smicbee/CoffeeRoast/README.md

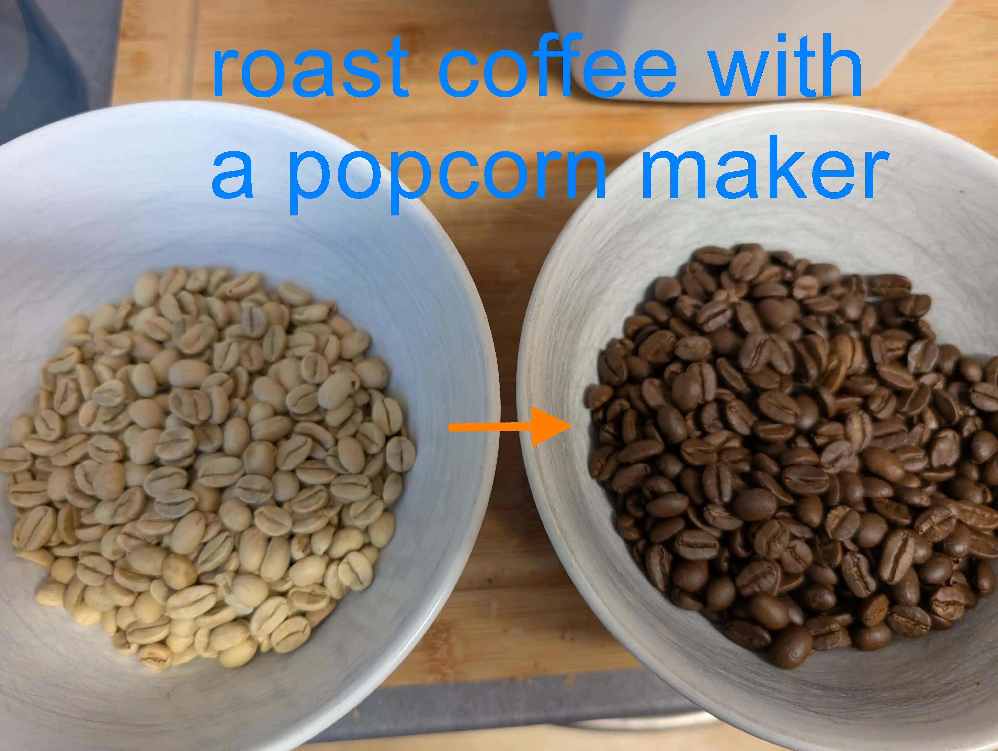
[picture p1: docu/assets/img/rel/headline.webp]
CoffeeRoast headline image for social media


# CoffeeRoast

We built a coffee roaster from a popcorn machine by adding temperature control. It follows a reproducible roast curve.

Kitchen flow


## Used Components

**Microcontroller:** LilyGo T-Display S3 ESP32-S3 (probably overkill, but it has a nice display and WiFi functionality if needed)  
From: [Amazon](https://www.amazon.de/LILYGO-T-Display-S3-Entwicklungsboard-Normalbildschirm-schwarzem/dp/B0BRTT727Z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)

**Popcorn Maker:** [Severin Popcorn-Maker](https://popcorn-rezepte.de/severin-pc-3751-popcornautomat-weiss-heissluft)  
From: Ebay/Kleinanzeigen for 5-10€. People often get this as a gift, use it once or not at all, and then sell it on eBay.

**Temperature Sensor:** MAX6675 Temperature Sensor, K Type  
From: [Amazon](https://www.amazon.de/dp/B0DFM7SJ3Z?ref=ppx_yo2ov_dt_b_fed_asin_title)

**Solid State Relay:** Solid-State-Relay SSR-40DA  
From: [Amazon](https://www.amazon.de/dp/B0CDKCBJRT?ref=ppx_yo2ov_dt_b_fed_asin_title)

Cables, drills, screwdriver, soldering iron

## Instructions

To modify the roaster, we had to:
* Add a temperature sensor
* Add a solid-state relay to the heater
* Add a PWM transistor to the fan

First, we took apart the popcorn maker. It basically consists of two elements: heating coils and a fan for the air.  
These popcorn makers are engineered to the limit, so please be gentle with them as they are made of a lot of plastic. We destroyed a couple until we got it right. Even then, the plastic melted on the third continuous roast.

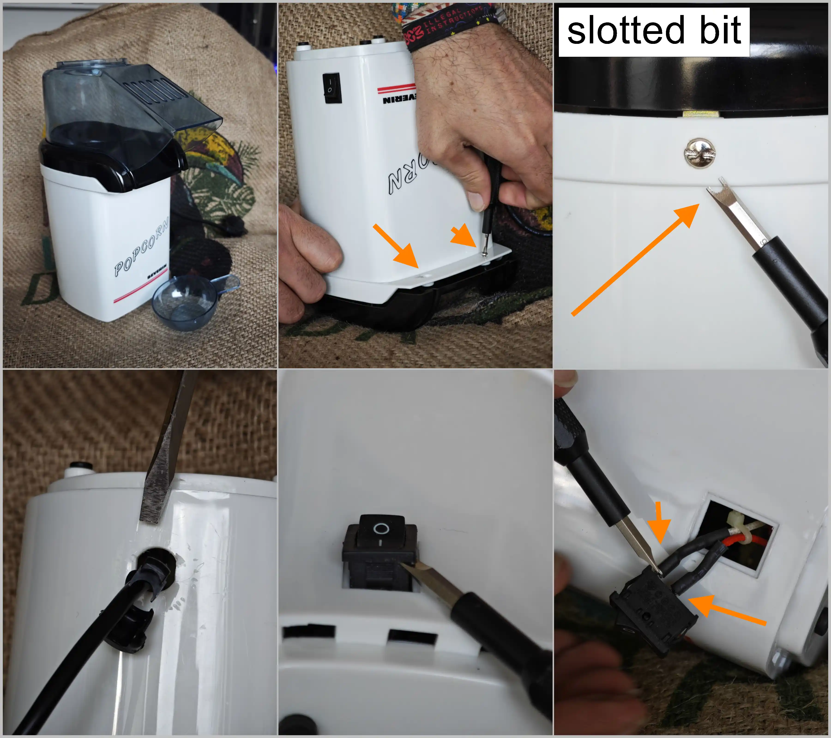
[picture p3: docu/assets/img/rel/open_case.webp]
Open popcorn maker casing


The main power switch connects the 230V from the outlet directly to the heating coils. The fan is connected to the heating coil in a way that ~24V AC goes through a rectifier (4 diodes) and is converted from AC to DC.

In the first step, we needed to decouple the heating coils from the fan and make the heating coil controllable using our solid-state relay. We disconnected the fan from the diodes so we could run it from an external power supply providing 24V later on.  
The heating coil was then soldered directly to the neutral conductor (blue wire). The red wire was cut, and the solid-state relay was installed in between so we could control the power of the heating element using PWM later.

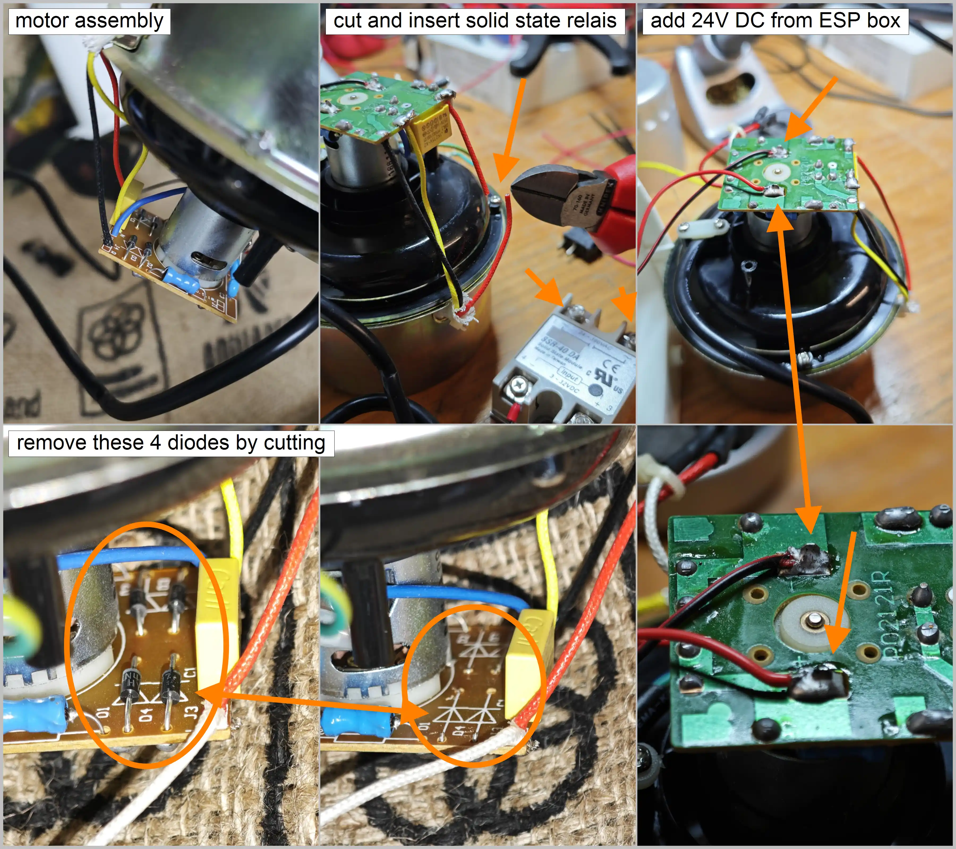
[picture p4: docu/assets/img/rel/power_motor_w_24V.webp]
Power and motor wiring with 24V supply


An external or lab power supply was used to provide 24V DC to the fan, so it runs permanently. The fan can take from 4V to 30V. We can adjust the voltage to control the speed or later use a GPIO, a diode, and a transistor to control it from the ESP32. The ESP ensures a smooth start of the fan. We broke one of the fans due to rapid spin up/down.

We drilled a hole in the top metal container to fit the thermocouple inside the roasting chamber.  
**Note:** If the temperature sensor touches the metal casing, it won't work properly. We insulated the sensor with Kapton tape or a non-conductive washer. The temperature reading is 0°C if the motor is spinning and no insulation was used. This is handled by the code to be filtered out, but the roaster will go into fail-safe mode after 30s of nonsensical temperature readings and spin up the fan to 100%.

The other 4 pins go into the ESP32 (VCC = 5V, GND = Ground, CLK = GPIO_13, CS = GPIO_12, DO = GPIO_11).

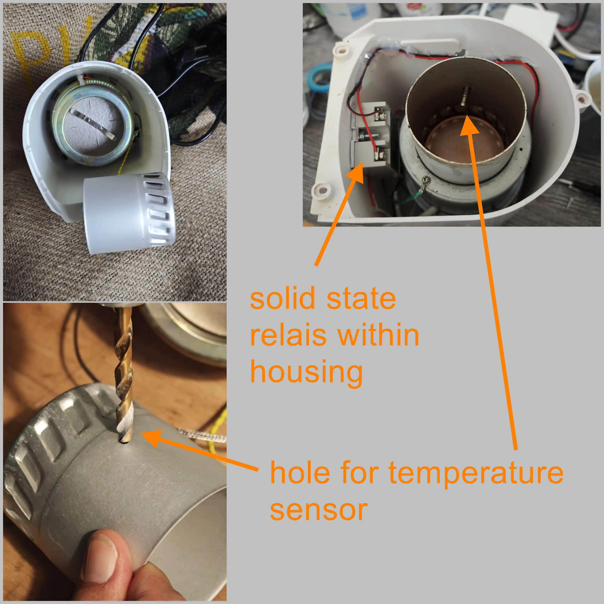
[picture p5: docu/assets/img/rel/add_sensor_and_hole.webp]
Thermocouple sensor installed in roasting chamber


Also, the solid-state relay is connected to the ESP32. In our case, the voltage provided by the GPIO was sufficient to control the solid-state relay, so we controlled it directly via the GPIO. If this does not work, you will need a separate transistor and a 5V supply for the SSR.  
The SSR uses GPIO_1 in our setup.

## Control Box

We 3D printed a box containing:
* ESP32
* 24V Fan PWM control
* SSR (solid-state relay) control
* Temperature sensor readout board

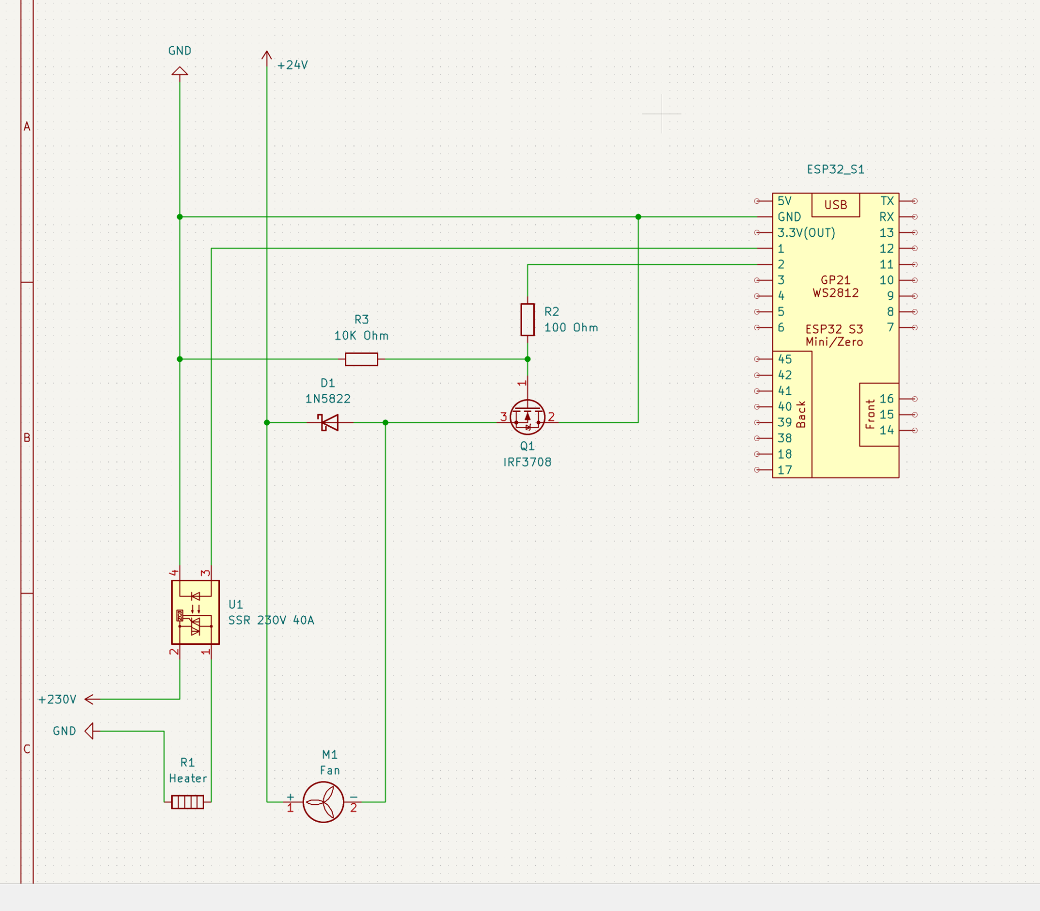
[picture p6: Schaltplan.png]
Wiring schematic of control box


And that's it!

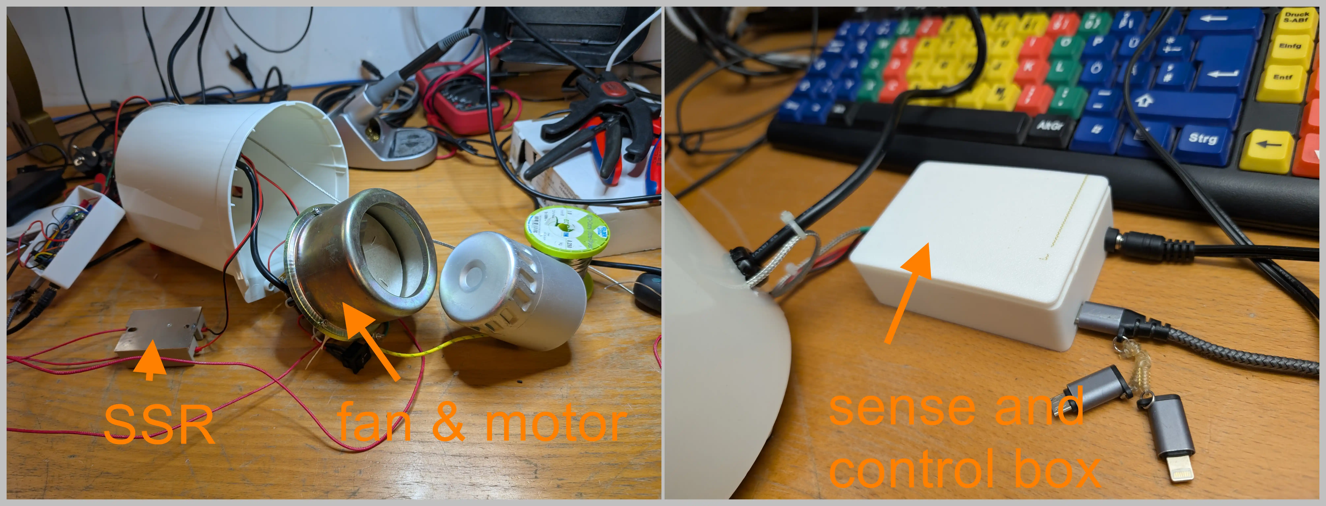
[picture p7: docu/assets/img/rel/assembly.webp]
Assembled control box with components


Initially, we wanted to use the ESP32 with Artisan (the software used for commercial products, e.g., Coffeelogic Nano), but we had no luck getting it to work with a PID. So, we decided to write our own software using C#. Communication is done via simple serial commands.  
You can send "get temp" via serial to the ESP32, and it will respond with the current temperature from the thermocouple.  
You can also send "set setpoint 255", which the ESP32 interprets to set the PWM duty cycle to 100% (255 = 100%, 128 = 50%, 0 = 0%).  
The firmware clamps `set setpoint` and `set fan` commands to the 0-255 PWM range and supports `get status` for a compact controller health line with state, temperature, heater, fan, fan target, and thermocouple error count.
The C# application can be found in the iRoastControl folder.

# Example Usage

Preparing the roaster for a new batch


Use no more than 100g of beans and roast in a well-ventilated area. Prepare for coffee skins flying _everywhere_.  
You can stop the roast at any time by flipping the on-off switch, which effectively disconnects the heater while keeping the cooling fan running.

[12s_roast.webm](https://github.com/user-attachments/assets/c60a7ab9-1068-4cd1-9d56-9880ee272cc1)

[12s video of 12min roasting](docu/assets/img/rel/12s_roast.webm)

# CoffeeRoast V2 Web

Die neue Steuerungsoberfläche liegt unter [`CoffeeRoast V2/`](CoffeeRoast%20V2/) und ist als moderne, responsive Webanwendung umgesetzt.

- Live-Verbindung zum bestehenden ESP32 über die Web Serial API
- vorhandenes serielles Protokoll und alle `.kpro`-Rezepte bleiben nutzbar
- Safety-Preflight, Failsafe, Vorheizen, Rösten und Abkühlen
- eingebauter Simulator, Canvas-Live-Plot und CSV-Export
- öffentlich bereitgestellt unter **https://coffeeroast.michaelbeetz.de/**

Für die USB-Verbindung wird Chrome oder Edge benötigt. Der Browser spricht direkt mit dem lokal ausgewählten USB-Gerät; der Webserver erhält keinen Zugriff auf den Controller.

# iRoastControl (Legacy)

iRoastControl is the control software. It comes with predefined roast curves you can use for your first roast.

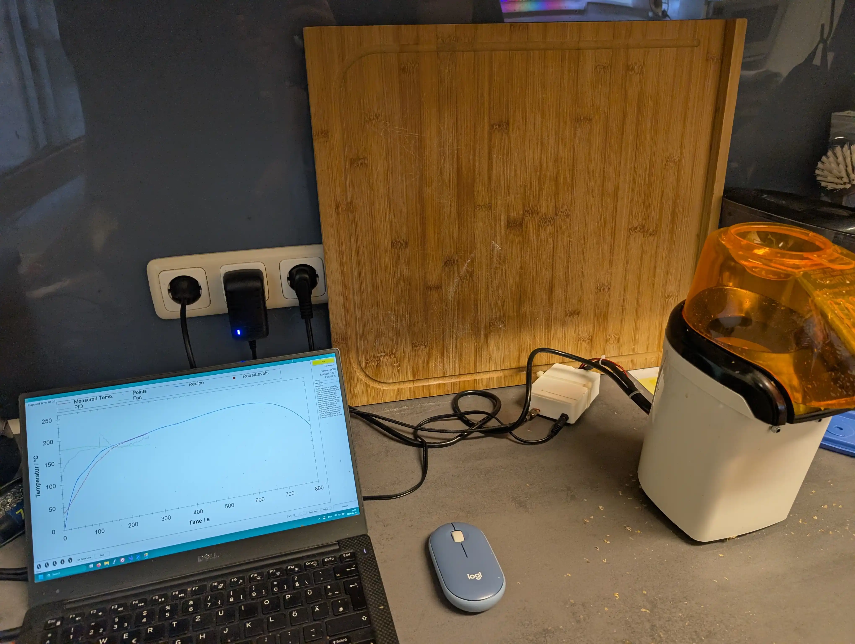
[picture p9: docu/assets/img/rel/roasting.webp]
iRoastControl software roasting curve view


## Build and Run on Windows

iRoastControl is a Windows Forms application for .NET Framework 4.7.2. Build it with Visual Studio 2022 and the ".NET desktop development" workload installed, including the .NET Framework 4.7.2 targeting pack or developer pack.

1. Connect the ESP32 roaster controller to the Windows PC over USB and confirm it appears as a COM port.
2. Open `iRoastControl Software/iRoastControl.sln` in Visual Studio.
3. Restore NuGet packages when Visual Studio prompts you, or use **Build > Restore NuGet Packages** before the first build. The project uses `packages.config`, so packages are restored into a repository-level `packages` folder.
4. Build the `Debug|Any CPU` or `Release|Any CPU` configuration, then press **Start** in Visual Studio or run the generated `iRoastControl.exe` from `iRoastControl Software/bin/Debug/` or `iRoastControl Software/bin/Release/`.

On startup the application scans available COM ports at `115200` baud, 8 data bits, no parity, one stop bit, and no handshake. It sends `hello` and expects the ESP32 firmware to answer `popcorn roaster`; after that it sends commands such as `get temp`, `set setpoint <0-255>`, and `set fan <0-255>`. If the app does not connect, check that the ESP32 firmware is running, no serial monitor has the port open, and the USB driver exposes the board as a COM port.

Roast recipes are loaded from the `Recipes` folder next to the running application. The source recipes live in `iRoastControl Software/Recipes/*.kpro` and are copied to the build output during the Visual Studio build. Add custom `.kpro` files to that folder before building, or copy them into `bin/Debug/Recipes/` or `bin/Release/Recipes/` beside the executable.

## First-Run Calibration and Safety Check

Before the first heated run, flash the ESP32 firmware, start iRoastControl, and leave the chamber empty. When you press "Run" from idle, the application requests `get status` from the controller and shows a preflight checklist. Confirm only after the thermocouple is insulated from the metal chamber, the fan moves air freely, the SSR is wired through the controller, ventilation is running, and the manual power cut-off is reachable.

Each roasting curve has three phases: pre-heating, running, and cool-down. When you click "Run" the first time, the application pre-heats the empty popcorn machine until the thermocouple reaches 180°C. This is when you add your coffee beans. After that, press "Run" again and the button will turn yellow. This is where the roasting curve starts. You can follow your roasting temperatures by watching the red graph. Pressing the "Run" button again will abort and start the cool-down phase, where the heating element turns off and only the fan runs. When the temperature drops below 60°C, the app returns to idle.

If the thermocouple returns repeated impossible readings, the firmware enters failsafe, turns the heater off, and drives the fan to 255/255. The app also treats a controller status containing `failsafe` as a blocked start until the wiring or sensor issue is fixed.

## UI

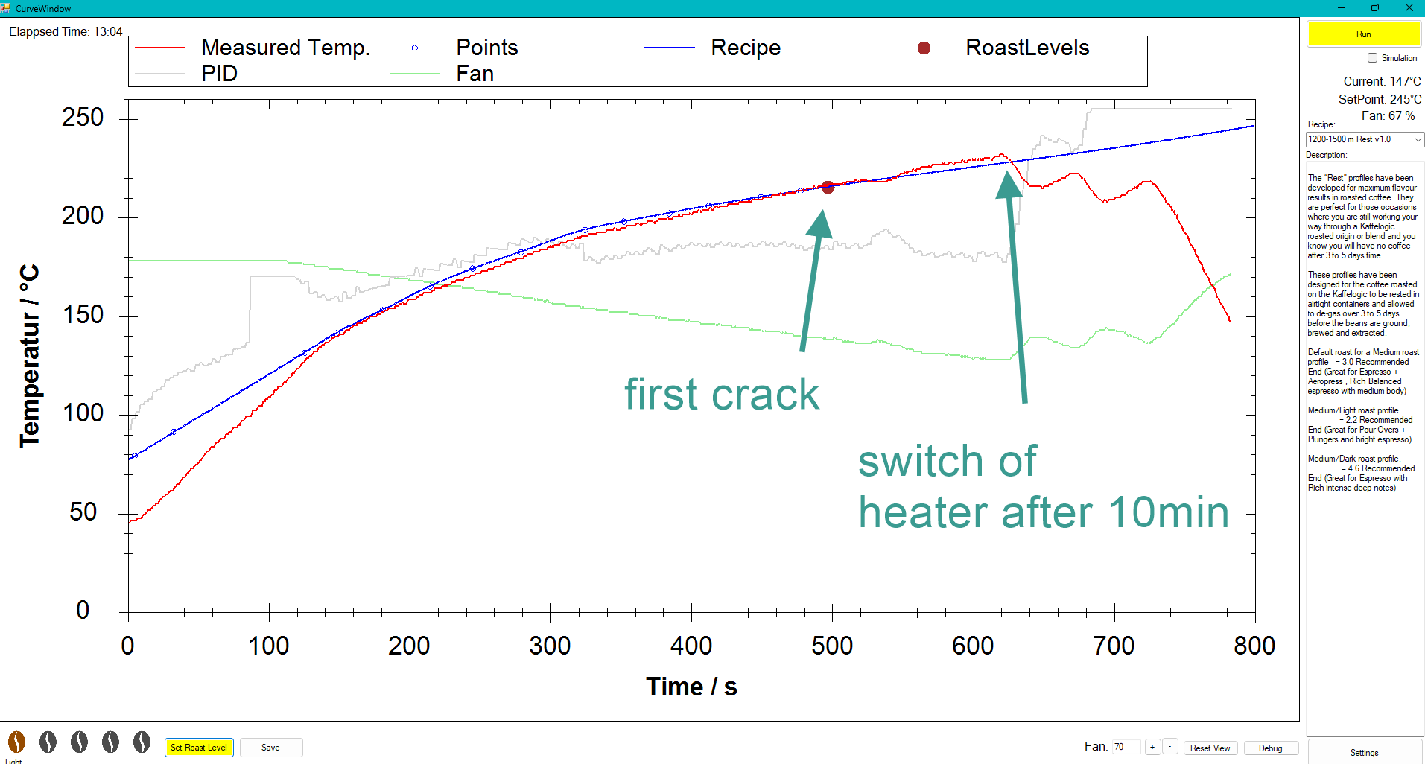
[picture p10: docu/assets/img/rel/iroastcontrol_overview.png]
iRoastControl software UI overview


At the moment, the curves are defined by some points in the source code, which get interpolated using a CubicSpline function. You can find the key points in `ControlClass.cs` in the function `generateDefaultCurve()`. Each point describes the temperature depending on the time in seconds, e.g., `targetPoints.Add(new PointF(660, 180));` means at 660s of the roasting curve, we should reach 180°C.  
Adjust as you like.

# Fails

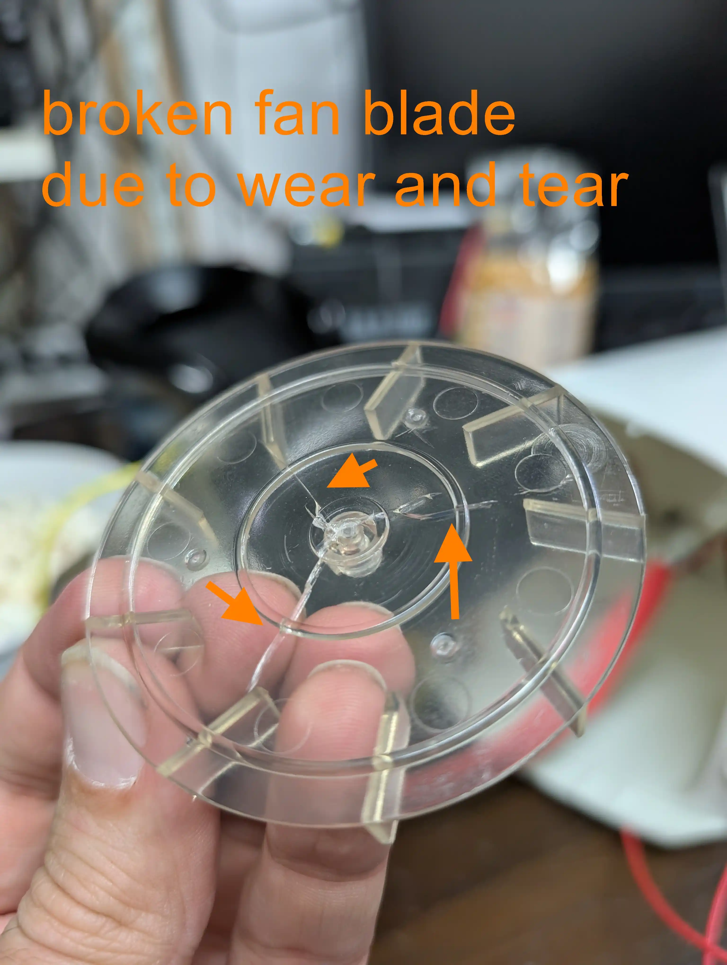
[picture p11: docu/assets/img/rel/fan_blade.webp]
Broken fan blade from old popcorn maker


If the popcorn maker is old (like 20 years), the fan blades are rather brittle and may break easily if used on full power.

**Note:** If the temperature sensor touches the metal casing, it won't work properly. We recommend insulating the sensor with Kapton tape or a non-conductive washer.

# Tips

* Cover any holes on top with Kapton tape to retain heat better. Plastic might melt a bit, though.
* Test the roast with actual popcorn, as it's cheaper if anything goes wrong.
* Experiment and change only one setting at a time.

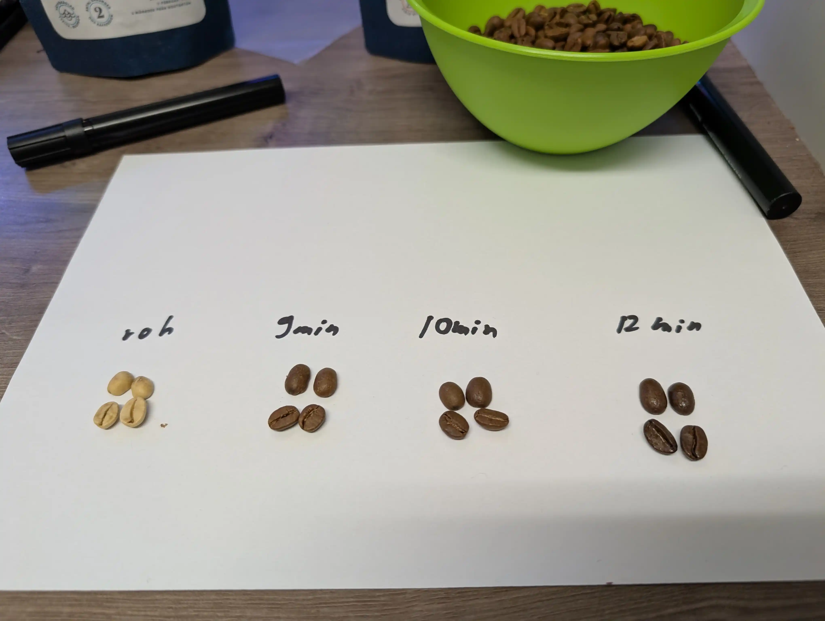
[picture p12: docu/assets/img/rel/result.webp]
Roasted coffee beans colors vs roast duration
