smicbee/CoffeeRoast/KiCAD/CoffeeRoast-Control-RevA/render/drc_report_after_silkscreen_cleanup.txt

** Drc report for CoffeeRoast-Control-RevA.kicad_pcb **
** Created on 2026-07-05T09:41:31+0200 **
** Report includes: Fehler, Warnungen **

** Found 110 DRC violations **
[silk_overlap]: Bestückungsdrucküberlappung
    Regel: Einschränkungen aus Platinenkonfiguration zum Bestückungsdruck; warning
    @(50,0000 mm, 82,6000 mm): Referenzfeld von TPGND
    @(50,0000 mm, 69,0000 mm): Abschnitt von U4 auf F.Silkscreen
[silk_over_copper]: Bestückungsdruck überlappt Lötstoppmaske
    Lokale Überschreibung; warning
    @(126,8500 mm, 30,4000 mm): Abschnitt von R8 auf F.Silkscreen
[silk_over_copper]: Bestückungsdruck überlappt Lötstoppmaske
    Lokale Überschreibung; warning
    @(126,8500 mm, 31,6000 mm): Abschnitt von R8 auf F.Silkscreen
[silk_over_copper]: Bestückungsdruck überlappt Lötstoppmaske
    Lokale Überschreibung; warning
    @(129,1500 mm, 30,4000 mm): Abschnitt von R8 auf F.Silkscreen
[silk_over_copper]: Bestückungsdruck überlappt Lötstoppmaske
    Lokale Überschreibung; warning
    @(129,1500 mm, 31,6000 mm): Abschnitt von R8 auf F.Silkscreen
[silk_over_copper]: Bestückungsdruck überlappt Lötstoppmaske
    Lokale Überschreibung; warning
    @(40,0000 mm, 39,0000 mm): Abschnitt von SW2 auf F.Silkscreen
[silk_over_copper]: Bestückungsdruck überlappt Lötstoppmaske
    Lokale Überschreibung; warning
    @(40,0000 mm, 45,0000 mm): Abschnitt von SW2 auf F.Silkscreen
[silk_over_copper]: Bestückungsdruck überlappt Lötstoppmaske
    Lokale Überschreibung; warning
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
[text_height]: Schrifthöhe außerhalb des zulässigen Bereichs (Einschränkungen aus Platinenkonfiguration zur Bestückungsdruckhöhe min. Breite 0,8000 mm; tatsächlich 0,6500 mm)
    Regel: Einschränkungen aus Platinenkonfiguration zur Bestückungsdruckhöhe; warning
    @(112,6000 mm, 46,5500 mm): Platinen-Text "IO37" auf B.Silkscreen
[text_height]: Schrifthöhe außerhalb des zulässigen Bereichs (Einschränkungen aus Platinenkonfiguration zur Bestückungsdruckhöhe min. Breite 0,8000 mm; tatsächlich 0,6500 mm)
    Regel: Einschränkungen aus Platinenkonfiguration zur Bestückungsdruckhöhe; warning
    @(112,6000 mm, 51,6300 mm): Platinen-Text "IO35" auf B.Silkscreen
[text_height]: Schrifthöhe außerhalb des zulässigen Bereichs (Einschränkungen aus Platinenkonfiguration zur Bestückungsdruckhöhe min. Breite 0,8000 mm; tatsächlich 0,6500 mm)
    Regel: Einschränkungen aus Platinenkonfiguration zur Bestückungsdruckhöhe; warning
    @(112,6000 mm, 54,1700 mm): Platinen-Text "IO0" auf B.Silkscreen
[text_height]: Schrifthöhe außerhalb des zulässigen Bereichs (Einschränkungen aus Platinenkonfiguration zur Bestückungsdruckhöhe min. Breite 0,8000 mm; tatsächlich 0,6500 mm)
    Regel: Einschränkungen aus Platinenkonfiguration zur Bestückungsdruckhöhe; warning
    @(112,6000 mm, 49,0900 mm): Platinen-Text "IO36" auf B.Silkscreen

** Found 0 unconnected pads **

** Found 0 Footprint errors **

** End of Report **
