smicbee/CoffeeRoast/KiCAD/CoffeeRoast-Control-RevA/render/drc_report_errors_only.txt

** Drc report for CoffeeRoast-Control-RevA.kicad_pcb **
** Created on 2026-07-05T19:19:03+0200 **
** Report includes: Fehler **

** Found 0 DRC violations **

** Found 0 unconnected pads **

** Found 0 Footprint errors **

** End of Report **
