smicbee/CoffeeRoast/KiCAD/CoffeeRoast-Control-RevA/render/drc_report_errors_only_after_silkscreen_cleanup.txt

** Drc report for CoffeeRoast-Control-RevA.kicad_pcb **
** Created on 2026-07-05T09:42:38+0200 **
** Report includes: Fehler **

** Found 0 DRC violations **

** Found 0 unconnected pads **

** Found 0 Footprint errors **

** End of Report **
