smicbee/CoffeeRoast/KiCAD/CoffeeRoast-Control-RevA/render/drc_report_full.txt

** Drc report for CoffeeRoast-Control-RevA.kicad_pcb **
** Created on 2026-07-05T09:37:32+0200 **
** Report includes: Fehler, Warnungen **

** Found 200 DRC violations **
[nonmirrored_text_on_back_layer]: Nicht-gespiegelter Text auf Rückseite
    Lokale Überschreibung; warning
    @(56,7000 mm, 21,1500 mm): Platinen-Text "GND" auf B.Silkscreen
[nonmirrored_text_on_back_layer]: Nicht-gespiegelter Text auf Rückseite
    Lokale Überschreibung; warning
    @(56,7000 mm, 23,6900 mm): Platinen-Text "3V3" auf B.Silkscreen
[nonmirrored_text_on_back_layer]: Nicht-gespiegelter Text auf Rückseite
    Lokale Überschreibung; warning
    @(56,7000 mm, 26,2300 mm): Platinen-Text "EN" auf B.Silkscreen
[nonmirrored_text_on_back_layer]: Nicht-gespiegelter Text auf Rückseite
    Lokale Überschreibung; warning
    @(56,7000 mm, 28,7700 mm): Platinen-Text "IO4" auf B.Silkscreen
[nonmirrored_text_on_back_layer]: Nicht-gespiegelter Text auf Rückseite
    Lokale Überschreibung; warning
    @(56,7000 mm, 31,3100 mm): Platinen-Text "IO5" auf B.Silkscreen
[nonmirrored_text_on_back_layer]: Nicht-gespiegelter Text auf Rückseite
    Lokale Überschreibung; warning
    @(56,7000 mm, 33,8500 mm): Platinen-Text "IO6" auf B.Silkscreen
[nonmirrored_text_on_back_layer]: Nicht-gespiegelter Text auf Rückseite
    Lokale Überschreibung; warning
    @(56,7000 mm, 36,3900 mm): Platinen-Text "IO7" auf B.Silkscreen
[nonmirrored_text_on_back_layer]: Nicht-gespiegelter Text auf Rückseite
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
    @(64,2500 mm, 74,5000 mm): Abschnitt von U3 auf F.Silkscreen
    @(72,0000 mm, 74,6000 mm): Referenzfeld von TP3V3
[silk_overlap]: Bestückungsdrucküberlappung
    Regel: Einschränkungen aus Platinenkonfiguration zum Bestückungsdruck; warning
    @(71,7500 mm, 74,5000 mm): Abschnitt von U3 auf F.Silkscreen
    @(72,0000 mm, 74,6000 mm): Referenzfeld von TP3V3
[silk_overlap]: Bestückungsdrucküberlappung
    Regel: Einschränkungen aus Platinenkonfiguration zum Bestückungsdruck; warning
    @(5,0000 mm, 44,5000 mm): Abschnitt von J2 auf F.Silkscreen
    @(10,0000 mm, 45,0000 mm): Referenzfeld von J2
[silk_overlap]: Bestückungsdrucküberlappung
    Regel: Einschränkungen aus Platinenkonfiguration zum Bestückungsdruck; warning
    @(43,0000 mm, 29,0000 mm): Referenzfeld von SW1
    @(40,0000 mm, 29,0000 mm): Abschnitt von SW1 auf F.Silkscreen
[silk_overlap]: Bestückungsdrucküberlappung
    Regel: Einschränkungen aus Platinenkonfiguration zum Bestückungsdruck; warning
    @(32,0000 mm, 15,0000 mm): Referenzfeld von F1
    @(19,0000 mm, 15,0000 mm): Abschnitt von F1 auf F.Silkscreen
[silk_overlap]: Bestückungsdrucküberlappung
    Regel: Einschränkungen aus Platinenkonfiguration zum Bestückungsdruck; warning
    @(10,0000 mm, 15,0000 mm): Referenzfeld von J1
    @(5,0000 mm, 14,5000 mm): Abschnitt von J1 auf F.Silkscreen
[silk_overlap]: Bestückungsdrucküberlappung
    Regel: Einschränkungen aus Platinenkonfiguration zum Bestückungsdruck; warning
    @(15,0000 mm, 21,5000 mm): Abschnitt von J1 auf F.Silkscreen
    @(10,0000 mm, 21,8000 mm): Referenzfeld von C4
[silk_overlap]: Bestückungsdrucküberlappung
    Regel: Einschränkungen aus Platinenkonfiguration zum Bestückungsdruck; warning
    @(50,0000 mm, 82,6000 mm): Referenzfeld von TPGND
    @(50,0000 mm, 69,0000 mm): Abschnitt von U4 auf F.Silkscreen
[silk_overlap]: Bestückungsdrucküberlappung
    Regel: Einschränkungen aus Platinenkonfiguration zum Bestückungsdruck; warning
    @(22,0000 mm, 70,6000 mm): Referenzfeld von TP24V
    @(22,0000 mm, 87,0000 mm): Abschnitt von U4 auf F.Silkscreen
[silk_overlap]: Bestückungsdrucküberlappung
    Regel: Einschränkungen aus Platinenkonfiguration zum Bestückungsdruck; warning
    @(56,1500 mm, 32,6000 mm): Abschnitt von R5 auf F.Silkscreen
    @(55,0000 mm, 33,0000 mm): Referenzfeld von R6
[silk_over_copper]: Bestückungsdruck überlappt Lötstoppmaske
    Lokale Überschreibung; warning
    @(132,0000 mm, 36,0000 mm): Platinen-Text "USB-C native data; VBUS sense only" auf F.Silkscreen
[silk_over_copper]: Bestückungsdruck überlappt Lötstoppmaske
    Lokale Überschreibung; warning
    @(109,0000 mm, 21,1500 mm): Platinen-Text "GND" auf B.Silkscreen
[silk_over_copper]: Bestückungsdruck überlappt Lötstoppmaske
    Lokale Überschreibung; warning
    @(109,0000 mm, 23,6900 mm): Platinen-Text "IO1" auf B.Silkscreen
[silk_over_copper]: Bestückungsdruck überlappt Lötstoppmaske
    Lokale Überschreibung; warning
    @(109,0000 mm, 26,2300 mm): Platinen-Text "IO2" auf B.Silkscreen
[silk_over_copper]: Bestückungsdruck überlappt Lötstoppmaske
    Lokale Überschreibung; warning
    @(109,0000 mm, 28,7700 mm): Platinen-Text "TXD0" auf B.Silkscreen
[silk_over_copper]: Bestückungsdruck überlappt Lötstoppmaske
    Lokale Überschreibung; warning
    @(109,0000 mm, 31,3100 mm): Platinen-Text "RXD0" auf B.Silkscreen
[silk_over_copper]: Bestückungsdruck überlappt Lötstoppmaske
    Lokale Überschreibung; warning
    @(109,0000 mm, 33,8500 mm): Platinen-Text "IO42" auf B.Silkscreen
[silk_over_copper]: Bestückungsdruck überlappt Lötstoppmaske
    Lokale Überschreibung; warning
    @(109,0000 mm, 36,3900 mm): Platinen-Text "IO41" auf B.Silkscreen
[silk_over_copper]: Bestückungsdruck überlappt Lötstoppmaske
    Lokale Überschreibung; warning
    @(109,0000 mm, 38,9300 mm): Platinen-Text "IO40" auf B.Silkscreen
[silk_over_copper]: Bestückungsdruck überlappt Lötstoppmaske
    Lokale Überschreibung; warning
    @(109,0000 mm, 41,4700 mm): Platinen-Text "IO39" auf B.Silkscreen
[silk_over_copper]: Bestückungsdruck überlappt Lötstoppmaske
    Lokale Überschreibung; warning
    @(109,0000 mm, 44,0100 mm): Platinen-Text "IO38" auf B.Silkscreen
[silk_over_copper]: Bestückungsdruck überlappt Lötstoppmaske
    Lokale Überschreibung; warning
    @(109,0000 mm, 46,5500 mm): Platinen-Text "IO37" auf B.Silkscreen
[silk_over_copper]: Bestückungsdruck überlappt Lötstoppmaske
    Lokale Überschreibung; warning
    @(109,0000 mm, 51,6300 mm): Platinen-Text "IO35" auf B.Silkscreen
[silk_over_copper]: Bestückungsdruck überlappt Lötstoppmaske
    Lokale Überschreibung; warning
    @(109,0000 mm, 54,1700 mm): Platinen-Text "IO0" auf B.Silkscreen
[silk_over_copper]: Bestückungsdruck überlappt Lötstoppmaske
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
    @(109,0000 mm, 46,5500 mm): Platinen-Text "IO37" auf B.Silkscreen
[text_height]: Schrifthöhe außerhalb des zulässigen Bereichs (Einschränkungen aus Platinenkonfiguration zur Bestückungsdruckhöhe min. Breite 0,8000 mm; tatsächlich 0,6500 mm)
    Regel: Einschränkungen aus Platinenkonfiguration zur Bestückungsdruckhöhe; warning
    @(109,0000 mm, 51,6300 mm): Platinen-Text "IO35" auf B.Silkscreen
[text_height]: Schrifthöhe außerhalb des zulässigen Bereichs (Einschränkungen aus Platinenkonfiguration zur Bestückungsdruckhöhe min. Breite 0,8000 mm; tatsächlich 0,6500 mm)
    Regel: Einschränkungen aus Platinenkonfiguration zur Bestückungsdruckhöhe; warning
    @(109,0000 mm, 54,1700 mm): Platinen-Text "IO0" auf B.Silkscreen
[text_height]: Schrifthöhe außerhalb des zulässigen Bereichs (Einschränkungen aus Platinenkonfiguration zur Bestückungsdruckhöhe min. Breite 0,8000 mm; tatsächlich 0,6500 mm)
    Regel: Einschränkungen aus Platinenkonfiguration zur Bestückungsdruckhöhe; warning
    @(109,2500 mm, 49,0900 mm): Platinen-Text "IO36" auf B.Silkscreen

** Found 0 unconnected pads **

** Found 0 Footprint errors **

** End of Report **
