smicbee/CoffeeRoast/KiCAD/CoffeeRoast-Control-RevA/render/drc_report_autorouted4.txt

** Drc report for CoffeeRoast-Control-RevA.kicad_pcb **
** Created on 2026-07-04T22:13:07+0200 **
** Report includes: Fehler, Warnungen **

** Found 89 DRC violations **
[silk_overlap]: Bestückungsdrucküberlappung
    Regel: Einschränkungen aus Platinenkonfiguration zum Bestückungsdruck; warning
    @(140,0000 mm, 49,0000 mm): Referenzfeld von J4
    @(135,0000 mm, 48,5000 mm): Abschnitt von J4 auf F.Silkscreen
[silk_overlap]: Bestückungsdrucküberlappung
    Regel: Einschränkungen aus Platinenkonfiguration zum Bestückungsdruck; warning
    @(135,0000 mm, 66,5000 mm): Abschnitt von J3 auf F.Silkscreen
    @(140,0000 mm, 67,0000 mm): Referenzfeld von J3
[silk_overlap]: Bestückungsdrucküberlappung
    Regel: Einschränkungen aus Platinenkonfiguration zum Bestückungsdruck; warning
    @(122,8500 mm, 41,4000 mm): Abschnitt von R10 auf F.Silkscreen
    @(124,0000 mm, 42,0000 mm): Referenzfeld von R11
[silk_overlap]: Bestückungsdrucküberlappung
    Regel: Einschränkungen aus Platinenkonfiguration zum Bestückungsdruck; warning
    @(122,8500 mm, 42,6000 mm): Abschnitt von R10 auf F.Silkscreen
    @(124,0000 mm, 42,0000 mm): Referenzfeld von R11
[silk_overlap]: Bestückungsdrucküberlappung
    Regel: Einschränkungen aus Platinenkonfiguration zum Bestückungsdruck; warning
    @(125,1500 mm, 41,4000 mm): Abschnitt von R10 auf F.Silkscreen
    @(124,0000 mm, 42,0000 mm): Referenzfeld von R11
[silk_overlap]: Bestückungsdrucküberlappung
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
    Lokale Überschreibung; warning
    @(95,1000 mm, 57,7000 mm): Abschnitt von U2 auf F.Silkscreen
[silk_over_copper]: Bestückungsdruck überlappt Lötstoppmaske
    Lokale Überschreibung; warning
    @(100,9000 mm, 52,3000 mm): Abschnitt von U2 auf F.Silkscreen
[silk_over_copper]: Bestückungsdruck überlappt Lötstoppmaske
    Lokale Überschreibung; warning
    @(45,0000 mm, 45,0000 mm): Referenzfeld von Q1
[silk_over_copper]: Bestückungsdruck überlappt Lötstoppmaske
    Lokale Überschreibung; warning
    @(124,0000 mm, 42,0000 mm): Referenzfeld von R11
[silk_over_copper]: Bestückungsdruck überlappt Lötstoppmaske
    Lokale Überschreibung; warning
    @(122,8500 mm, 44,4000 mm): Abschnitt von R11 auf F.Silkscreen
[silk_over_copper]: Bestückungsdruck überlappt Lötstoppmaske
    Lokale Überschreibung; warning
    @(122,8500 mm, 45,6000 mm): Abschnitt von R11 auf F.Silkscreen
[silk_over_copper]: Bestückungsdruck überlappt Lötstoppmaske
    Lokale Überschreibung; warning
    @(125,1500 mm, 44,4000 mm): Abschnitt von R11 auf F.Silkscreen
[silk_over_copper]: Bestückungsdruck überlappt Lötstoppmaske
    Lokale Überschreibung; warning
    @(125,1500 mm, 45,6000 mm): Abschnitt von R11 auf F.Silkscreen

** Found 0 unconnected pads **

** Found 0 Footprint errors **

** End of Report **
