smicbee/CoffeeRoast/KiCAD/CoffeeRoast-Control-RevA/render/kicad_happy/schematic.txt

=== Design Analysis [stage: pre_fab] ===
No findings.
