smicbee/CoffeeRoast/KiCAD/CoffeeRoast-Control-RevA/production/jlc-current-no-j1j4/drill/drill_report.txt

Drill report for CoffeeRoast-Control-RevA.kicad_pcb
Created on 2026-07-07T05:18:10+0200

Copper Layer Stackup:
    =============================================================
    L1 :  F.Cu                      front
    L2 :  B.Cu                      back

Drill file 'CoffeeRoast-Control-RevA.drl' contains
    plated through holes:
    =============================================================
    T1  0,300mm  0,0118"  (60 holes)
    T2  0,300mm  0,0118"  (12 holes)
    T3  0,600mm  0,0236"  (4 holes)  (with 4 slots)
    T4  0,800mm  0,0315"  (6 holes)
    T5  0,900mm  0,0354"  (10 holes)
    T6  1,000mm  0,0394"  (2 holes)
    T7  1,100mm  0,0433"  (7 holes)
    T8  1,300mm  0,0512"  (10 holes)

    Total plated holes count 111

Not plated through holes are merged with plated holes
    unplated through holes:
    =============================================================
    T9  0,650mm  0,0256"  (2 holes)

    Total unplated holes count 2
