smicbee/CoffeeRoast/tickets/76abb8d9-696f-4b31-948a-20c49ac45dec/description.md

# Rework UI

Die UI soll überarbeitet und schöner, moderner gemacht werden. auch der plot soll besser aussehen
