smicbee/CoffeeRoast/ESP32S3 Zero/RoastingControl/flashSettings.png

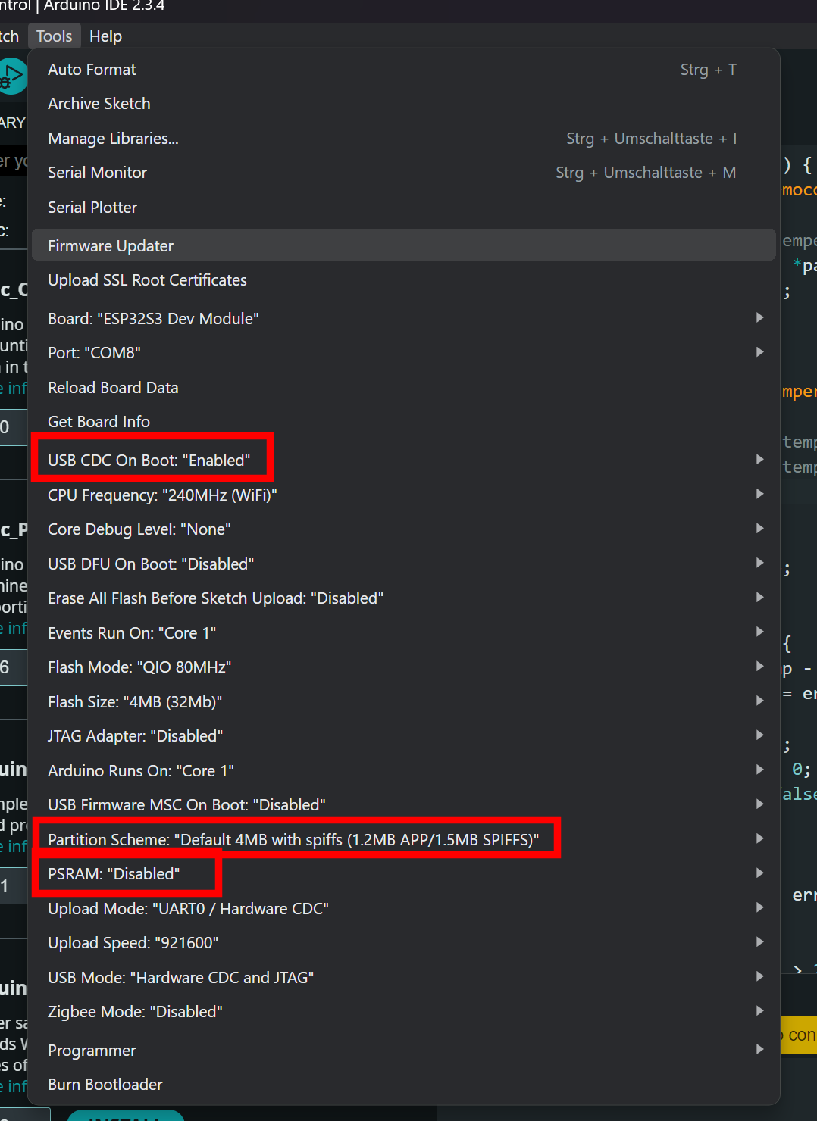
ESP32S3 Zero/RoastingControl/flashSettings.png
