smicbee/CoffeeRoast/iRoastControl Software/coffee-bean-256.png

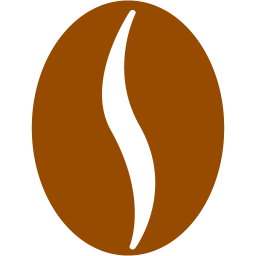
iRoastControl Software/coffee-bean-256.png
