smicbee/CoffeeRoast/KiCAD/CoffeeRoast-Control-RevA/docs/board_preview.png

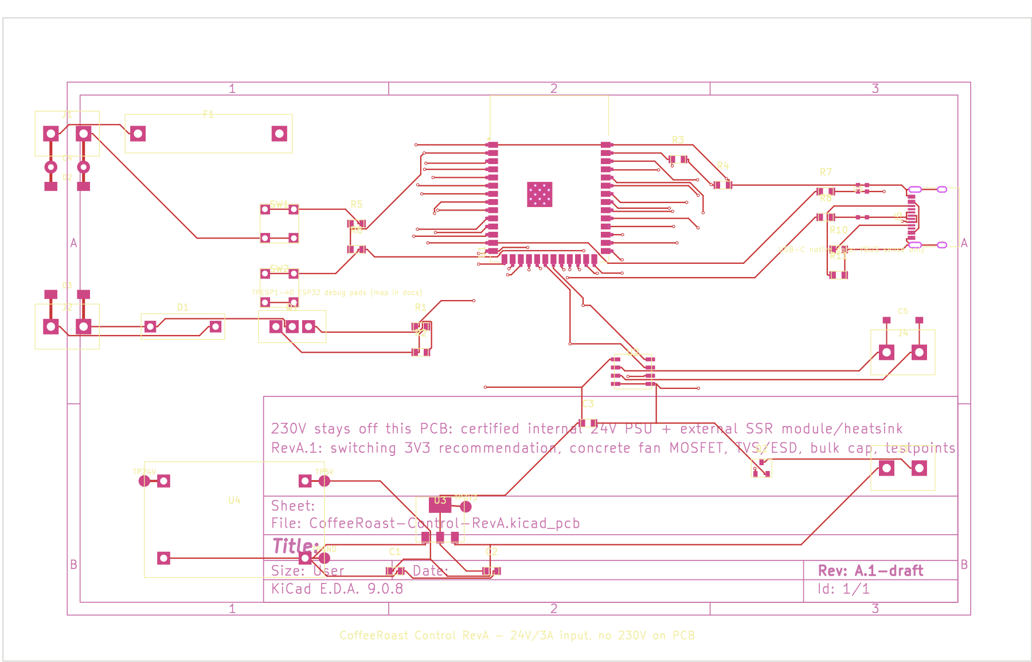
KiCAD/CoffeeRoast-Control-RevA/docs/board_preview.png
