smicbee/CoffeeRoast/KiCAD/CoffeeRoast-Control-RevA/render/back_kicad_happy_pass.png

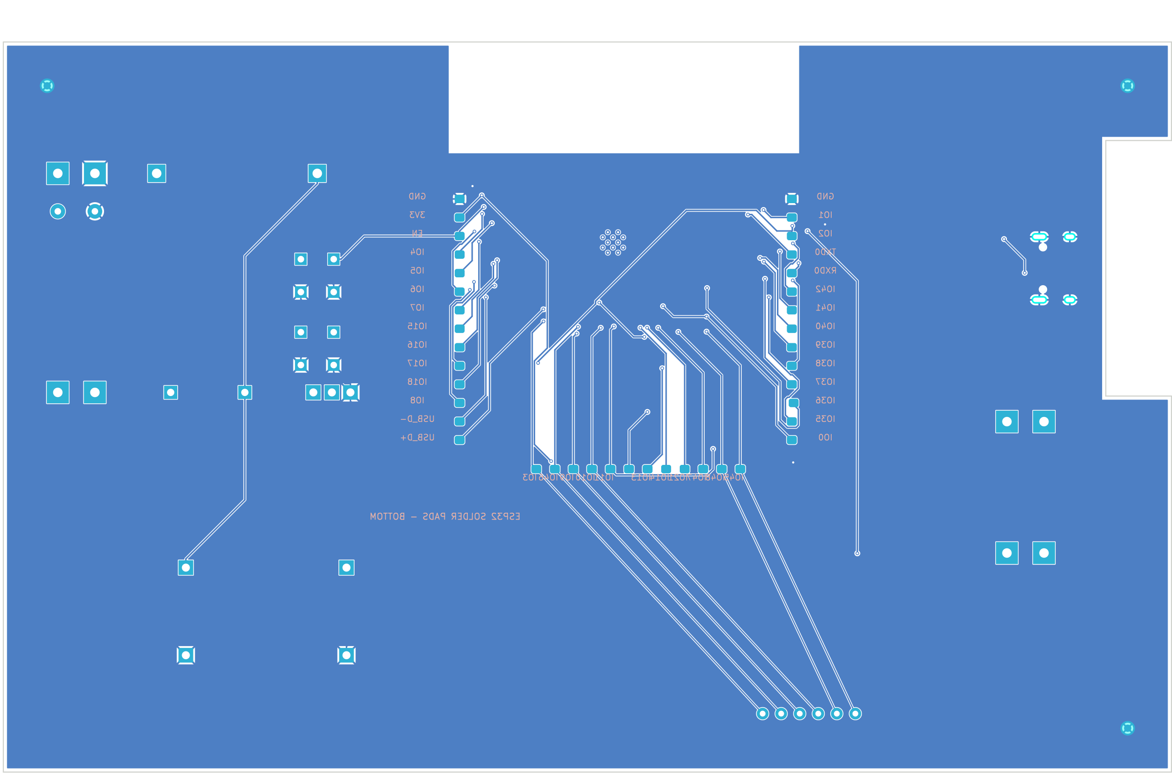
KiCAD/CoffeeRoast-Control-RevA/render/back_kicad_happy_pass.png
