smicbee/CoffeeRoast/KiCAD/CoffeeRoast-Control-RevA/render/back_silk_mask.png

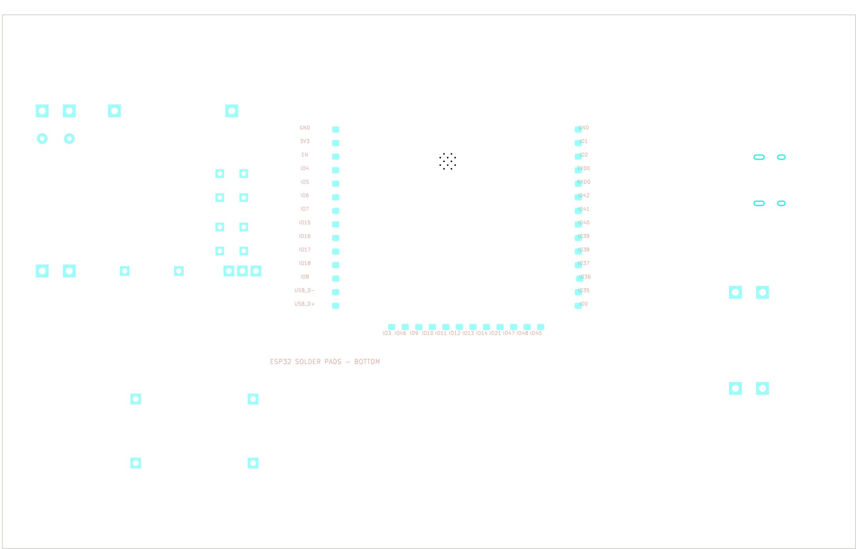
KiCAD/CoffeeRoast-Control-RevA/render/back_silk_mask.png
