smicbee/CoffeeRoast/KiCAD/CoffeeRoast-Control-RevA/render/coffeeroast_actual_traces_overlay.png

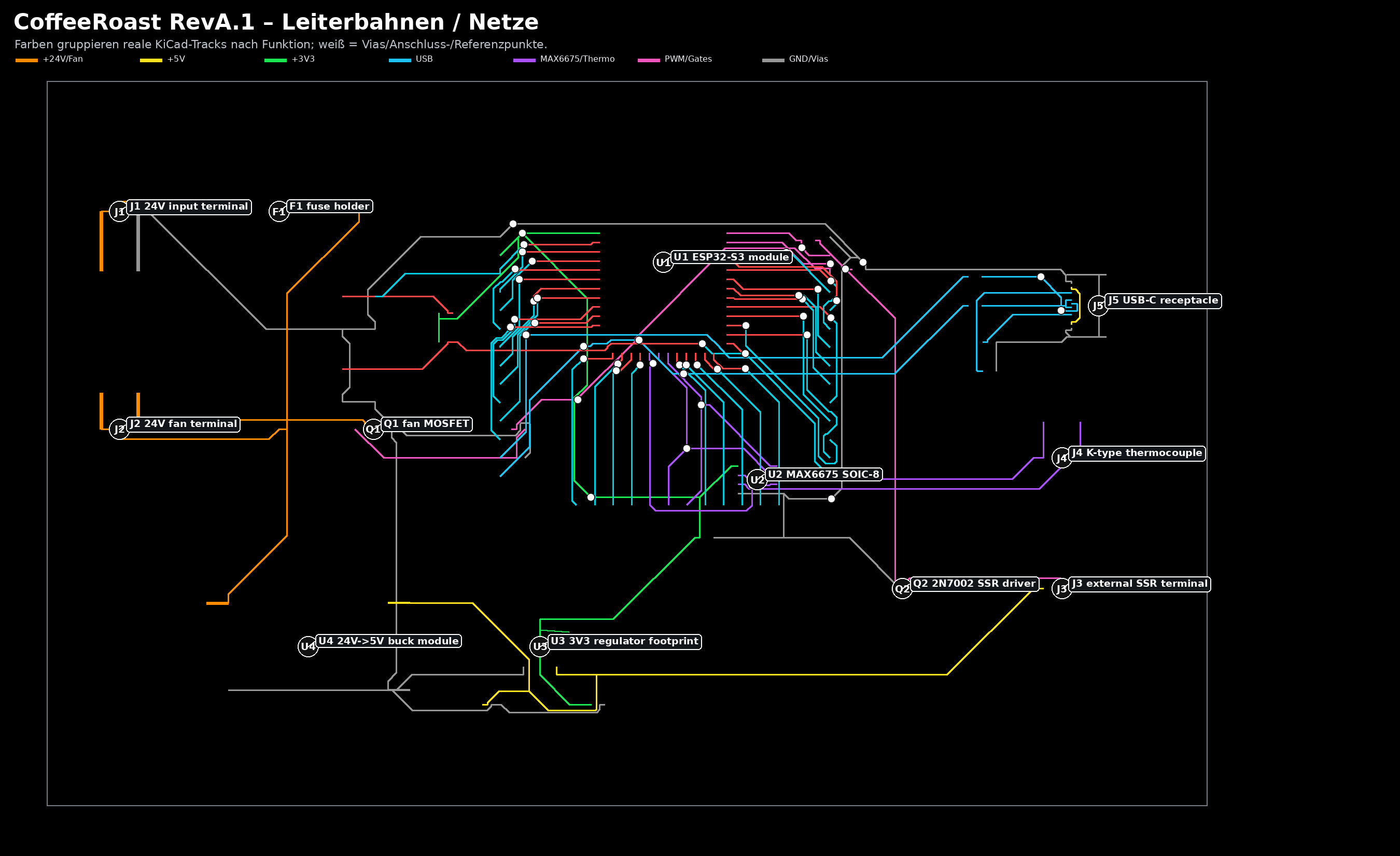
KiCAD/CoffeeRoast-Control-RevA/render/coffeeroast_actual_traces_overlay.png
