smicbee/CoffeeRoast/KiCAD/CoffeeRoast-Control-RevA/render/coffeeroast_functional_block_diagram.png

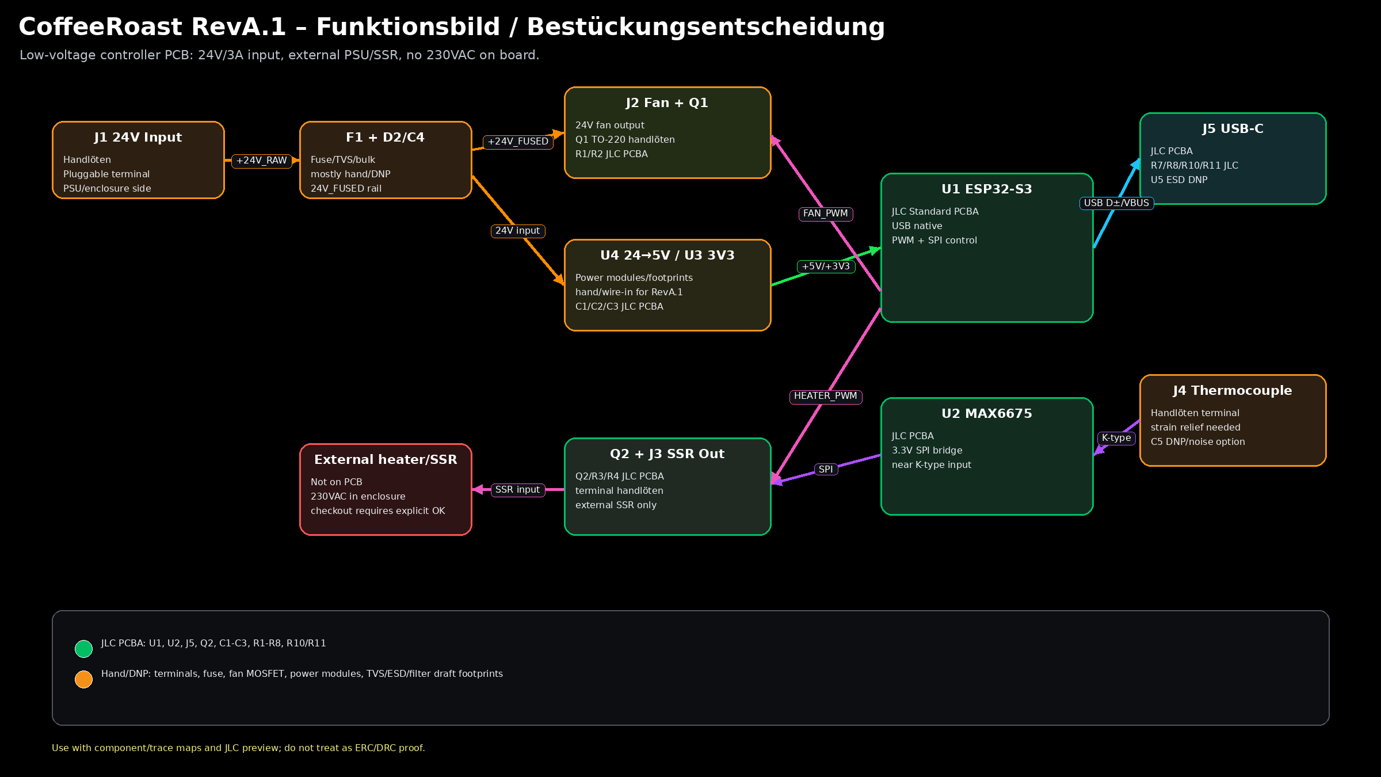
KiCAD/CoffeeRoast-Control-RevA/render/coffeeroast_functional_block_diagram.png
