smicbee/CoffeeRoast/KiCAD/CoffeeRoast-Control-RevA/render/coffeeroast_jlc_pcba_placement_annotated.png

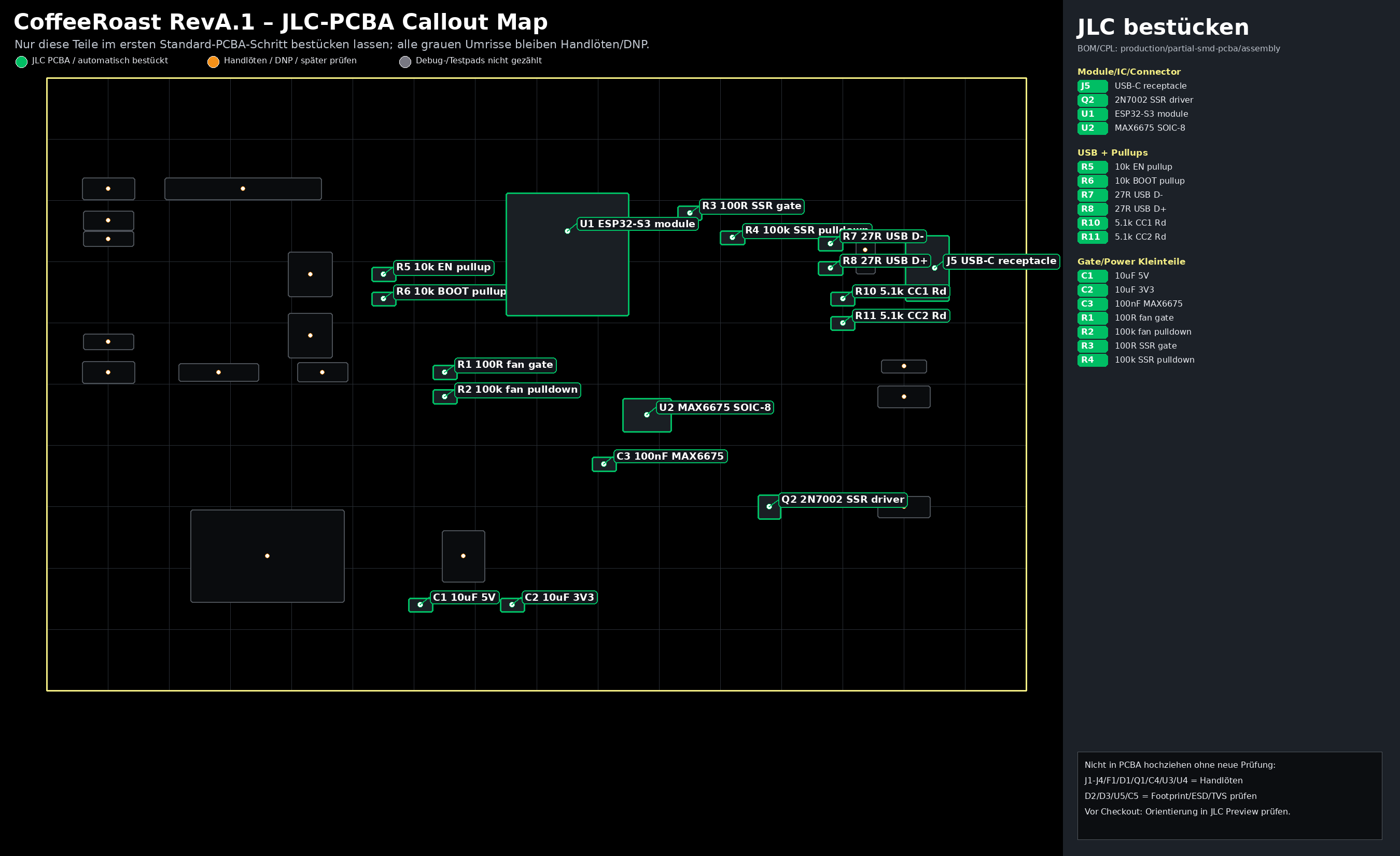
KiCAD/CoffeeRoast-Control-RevA/render/coffeeroast_jlc_pcba_placement_annotated.png
