smicbee/CoffeeRoast/KiCAD/CoffeeRoast-Control-RevA/render/front_gpio_labels.png

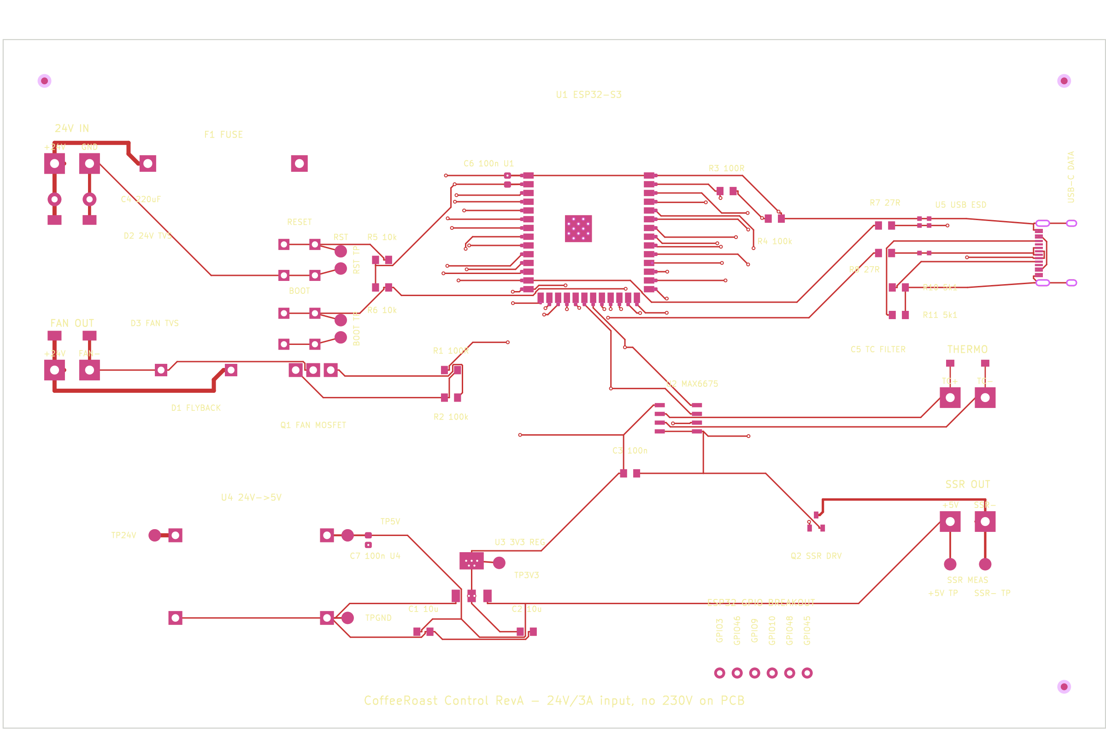
KiCAD/CoffeeRoast-Control-RevA/render/front_gpio_labels.png
