smicbee/CoffeeRoast/KiCAD/CoffeeRoast-Control-RevA/render/front_silk_mask.png

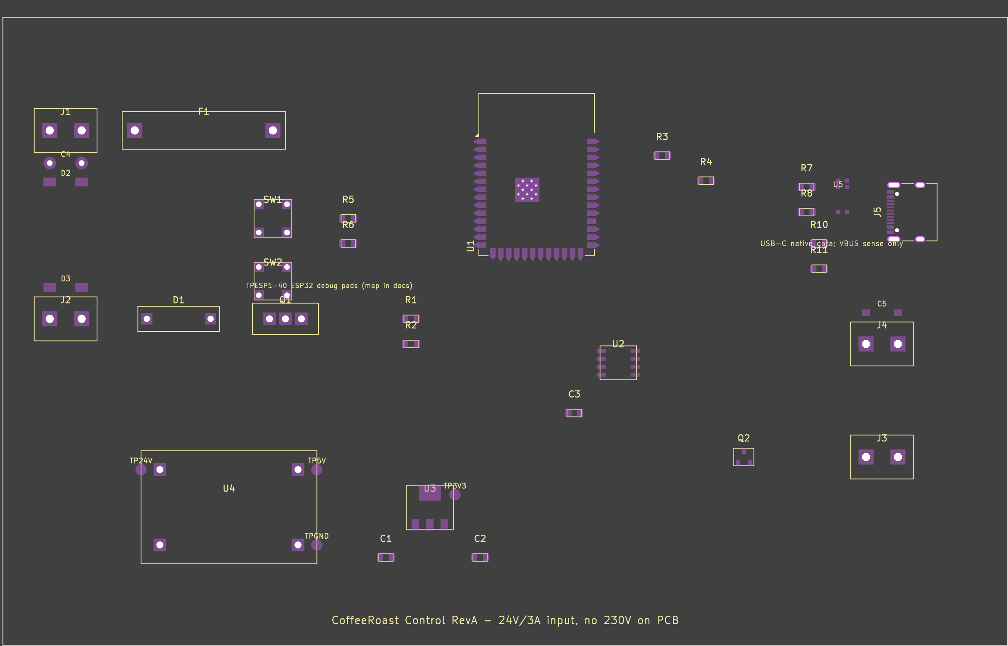
KiCAD/CoffeeRoast-Control-RevA/render/front_silk_mask.png
