smicbee/CoffeeRoast/KiCAD/CoffeeRoast-Control-RevA/render/front_silk_mask_clean.png

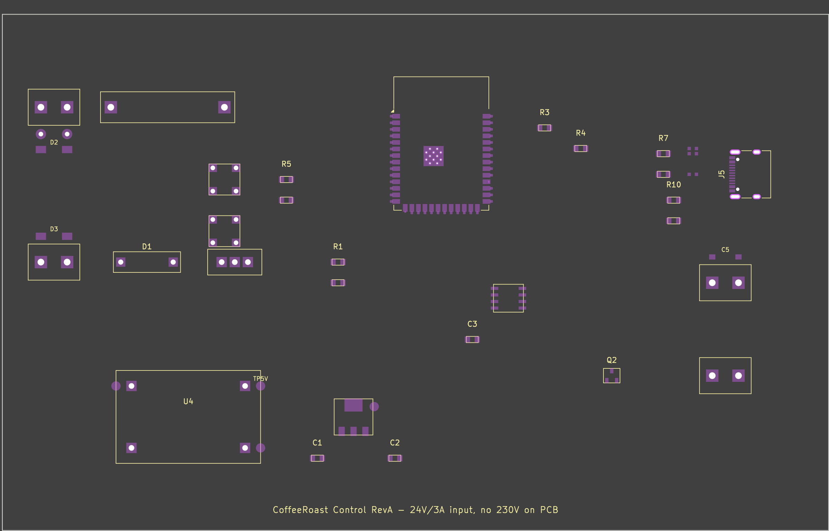
KiCAD/CoffeeRoast-Control-RevA/render/front_silk_mask_clean.png
