smicbee/CoffeeRoast/KiCAD/CoffeeRoast-Control-RevA/render/front_silk_mask_labeled.png

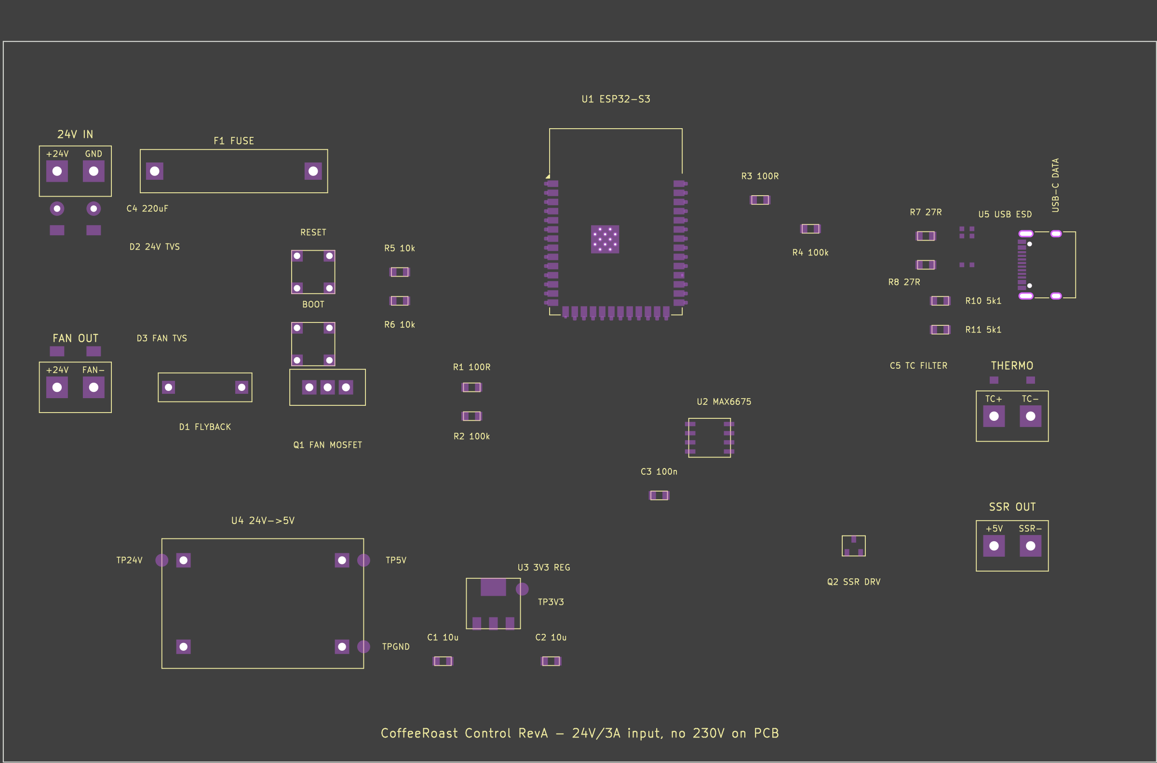
KiCAD/CoffeeRoast-Control-RevA/render/front_silk_mask_labeled.png
