smicbee/CoffeeRoast/KiCAD/CoffeeRoast-Control-RevA/render/jlc_upload_after_gerber_only_noj1j4.png

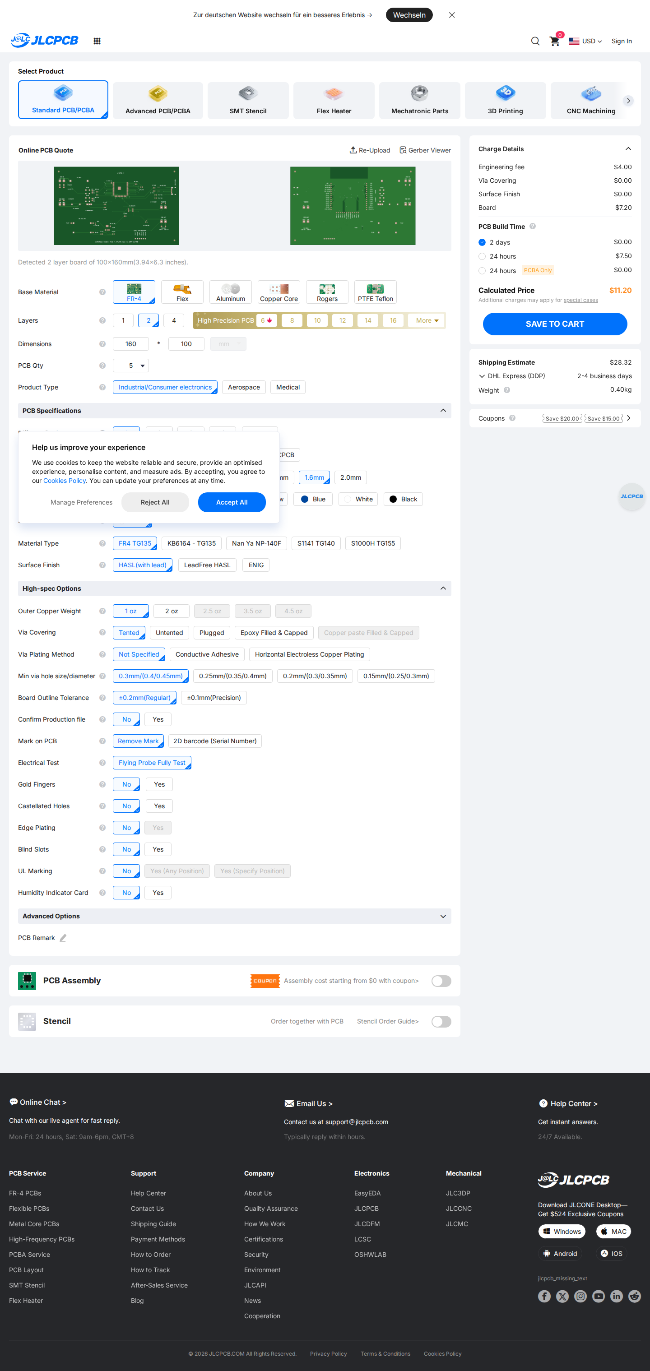
KiCAD/CoffeeRoast-Control-RevA/render/jlc_upload_after_gerber_only_noj1j4.png
