smicbee/CoffeeRoast/KiCAD/CoffeeRoast-Control-RevA/render/kicad_bottom.png

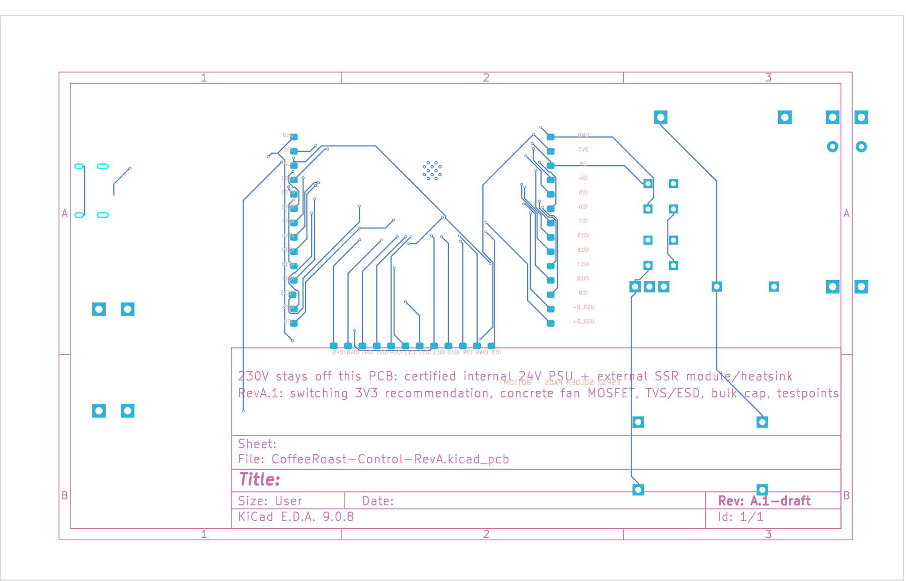
KiCAD/CoffeeRoast-Control-RevA/render/kicad_bottom.png
