smicbee/CoffeeRoast/KiCAD/CoffeeRoast-Control-RevA/render/label_cleanup/bottom_after.png

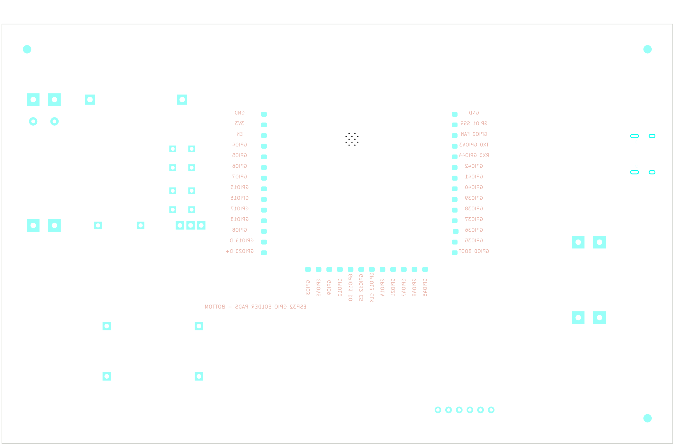
KiCAD/CoffeeRoast-Control-RevA/render/label_cleanup/bottom_after.png
