smicbee/CoffeeRoast/KiCAD/CoffeeRoast-Control-RevA/render/label_cleanup/bottom_after_back_pad_labels.png

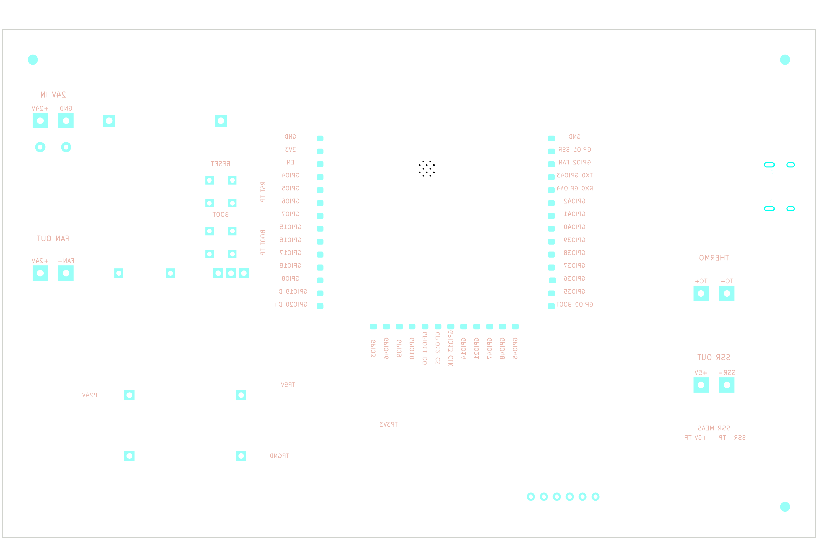
KiCAD/CoffeeRoast-Control-RevA/render/label_cleanup/bottom_after_back_pad_labels.png
