smicbee/CoffeeRoast/KiCAD/CoffeeRoast-Control-RevA/render/label_cleanup/bottom_after_readable_flipped.png

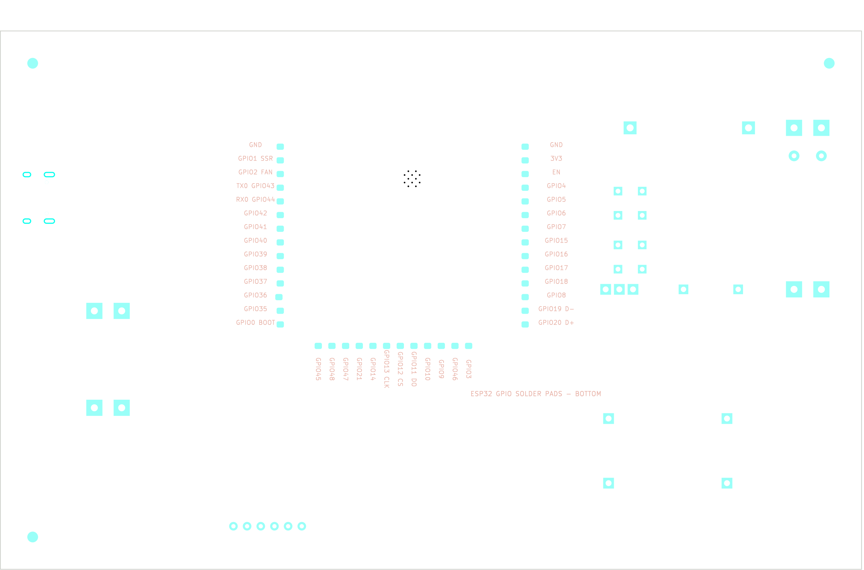
KiCAD/CoffeeRoast-Control-RevA/render/label_cleanup/bottom_after_readable_flipped.png
