smicbee/CoffeeRoast/KiCAD/CoffeeRoast-Control-RevA/render/label_cleanup/bottom_before.png

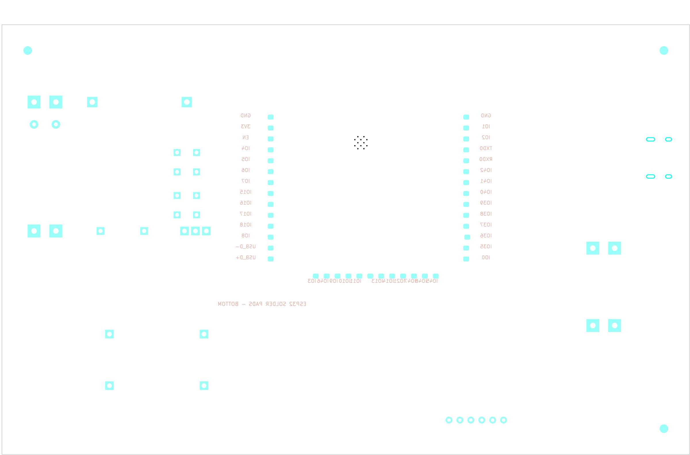
KiCAD/CoffeeRoast-Control-RevA/render/label_cleanup/bottom_before.png
