smicbee/CoffeeRoast/KiCAD/CoffeeRoast-Control-RevA/render/label_cleanup/front_after.png

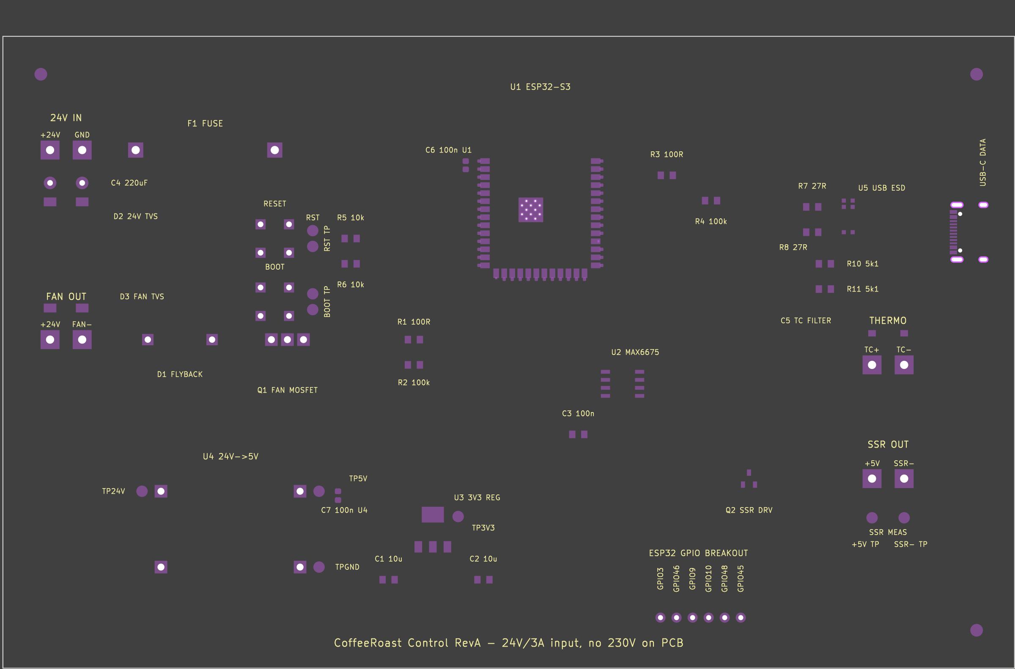
KiCAD/CoffeeRoast-Control-RevA/render/label_cleanup/front_after.png
