smicbee/CoffeeRoast/KiCAD/CoffeeRoast-Control-RevD-Balanced/mechanical/enclosure/generated/preview_closed.png

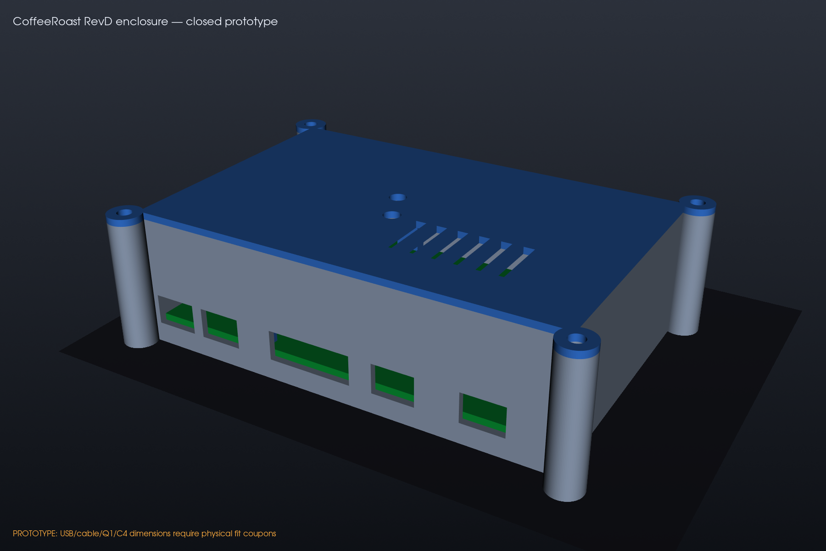
KiCAD/CoffeeRoast-Control-RevD-Balanced/mechanical/enclosure/generated/preview_closed.png
