smicbee/CoffeeRoast/KiCAD/CoffeeRoast-Control-RevD-Balanced/mechanical/enclosure/generated/preview_usb_side.png

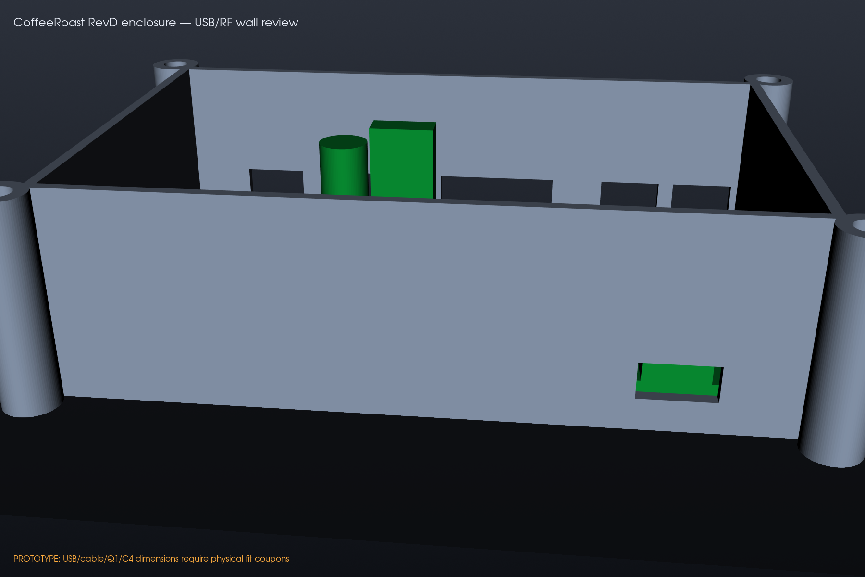
KiCAD/CoffeeRoast-Control-RevD-Balanced/mechanical/enclosure/generated/preview_usb_side.png
