smicbee/CoffeeRoast/KiCAD/CoffeeRoast-Control-RevD-Balanced/mechanical/enclosure/openscad/generated/preview_closed.png

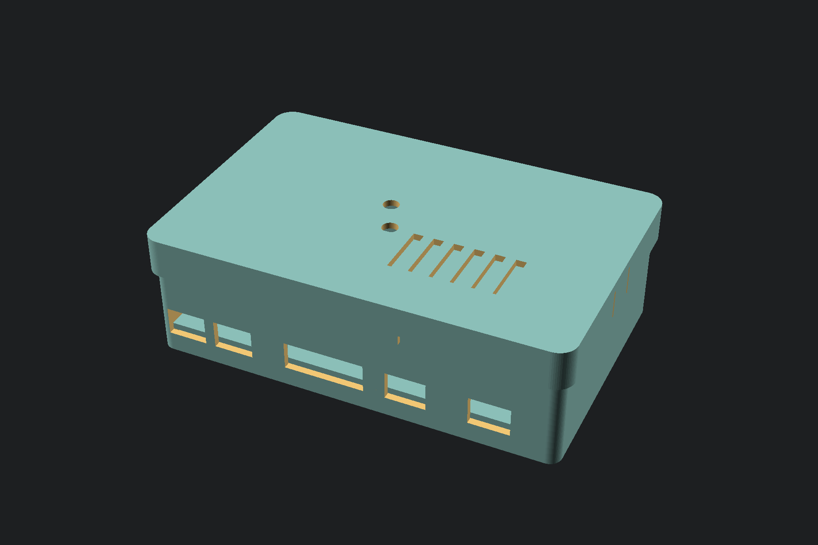
KiCAD/CoffeeRoast-Control-RevD-Balanced/mechanical/enclosure/openscad/generated/preview_closed.png
