smicbee/CoffeeRoast/KiCAD/CoffeeRoast-Control-RevD-Balanced/mechanical/enclosure/openscad/generated/preview_closed_rails_attached.png

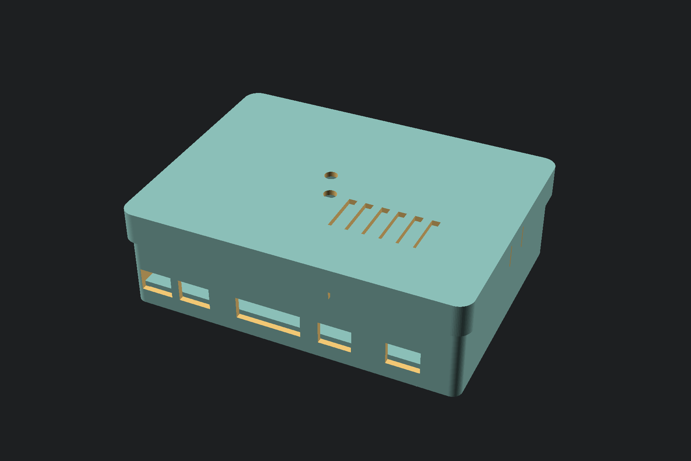
KiCAD/CoffeeRoast-Control-RevD-Balanced/mechanical/enclosure/openscad/generated/preview_closed_rails_attached.png
