smicbee/CoffeeRoast/KiCAD/CoffeeRoast-Control-RevD-Balanced/mechanical/enclosure/openscad/generated/preview_exploded.png

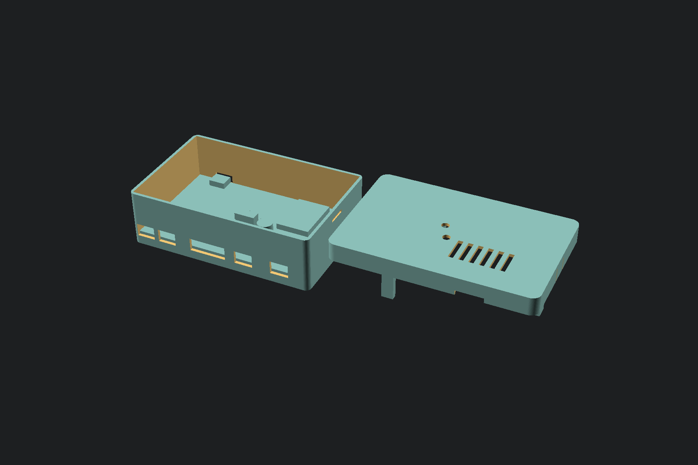
KiCAD/CoffeeRoast-Control-RevD-Balanced/mechanical/enclosure/openscad/generated/preview_exploded.png
