smicbee/CoffeeRoast/KiCAD/waveshare_esp32_s3_mini_zero_symbol.png

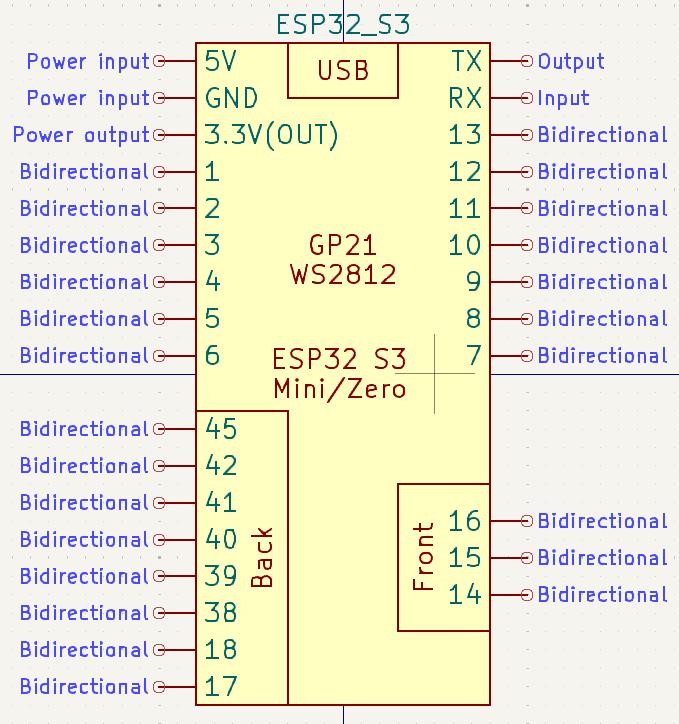
KiCAD/waveshare_esp32_s3_mini_zero_symbol.png
