smicbee/CoffeeRoast/mechanical/stacked-controller-psu-enclosure/openscad/generated/preview_ac.png

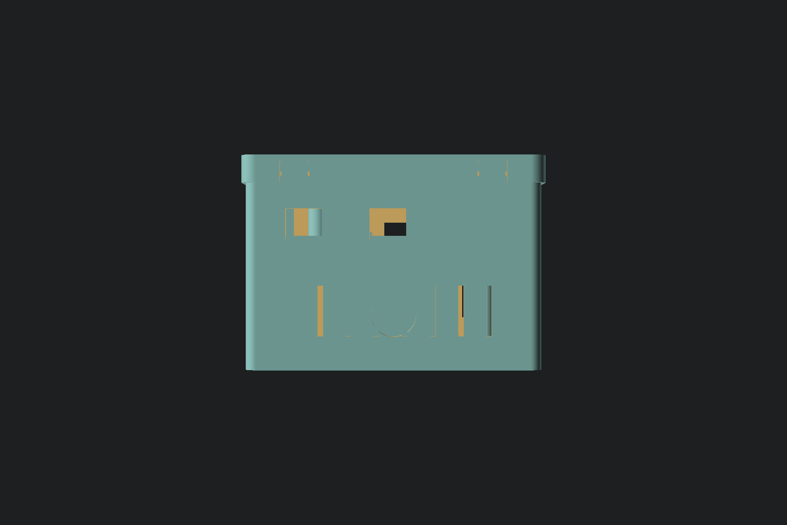
mechanical/stacked-controller-psu-enclosure/openscad/generated/preview_ac.png
