smicbee/CoffeeRoast/mechanical/stacked-controller-psu-enclosure/openscad/generated/preview_closed.png

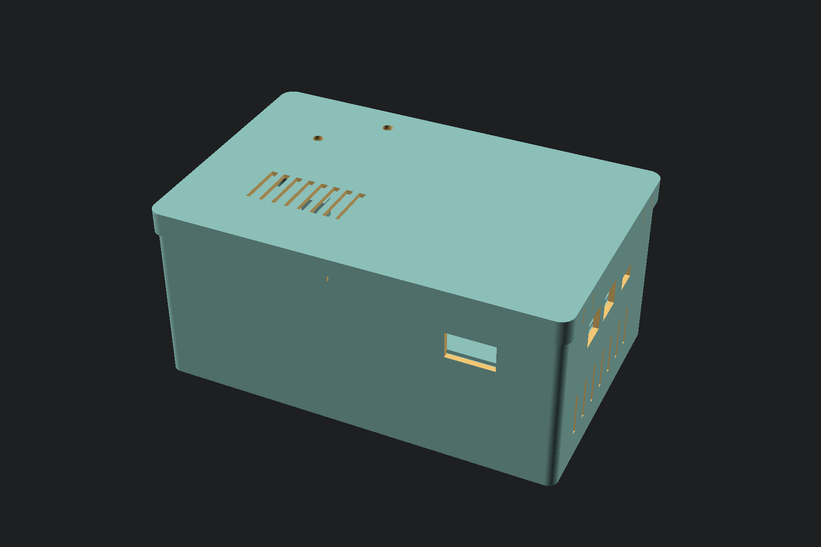
mechanical/stacked-controller-psu-enclosure/openscad/generated/preview_closed.png
