smicbee/CoffeeRoast/mechanical/stacked-controller-psu-enclosure/openscad/generated/preview_exploded.png

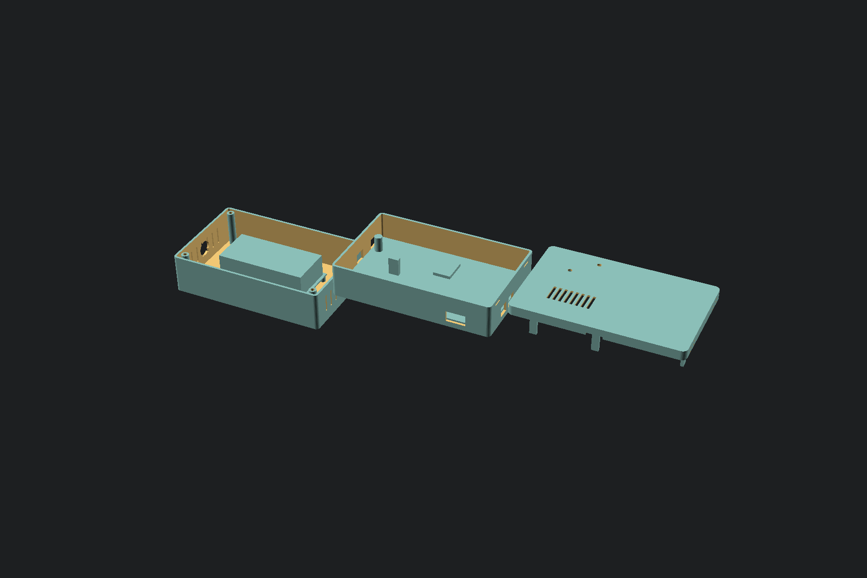
mechanical/stacked-controller-psu-enclosure/openscad/generated/preview_exploded.png
