smicbee/CoffeeRoast/KiCAD/CoffeeRoast-Control-RevA/render/coffeeroast_component_map_annotated.png

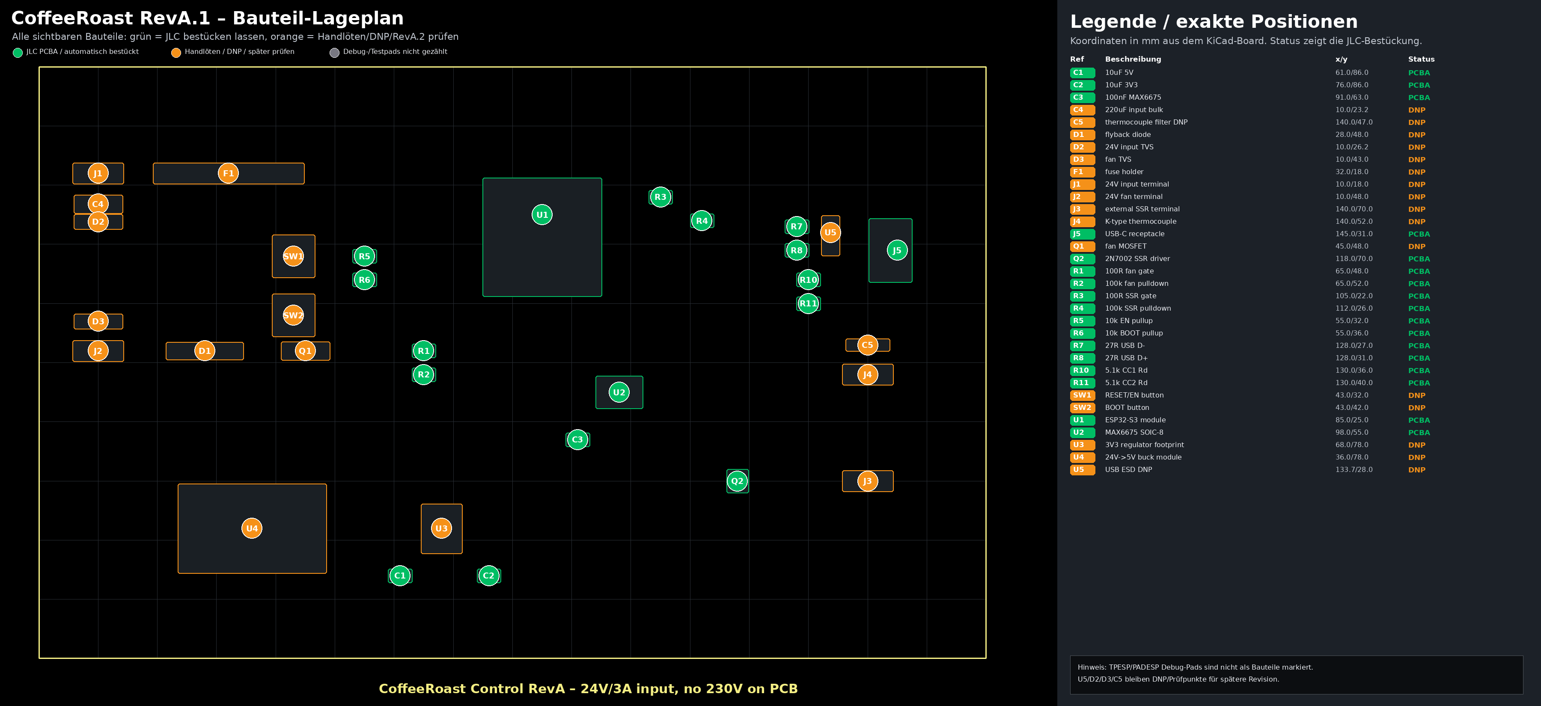
KiCAD/CoffeeRoast-Control-RevA/render/coffeeroast_component_map_annotated.png
