smicbee/CoffeeRoast/KiCAD/CoffeeRoast-Control-RevD-Balanced/mechanical/enclosure/generated/assembly_closed.step

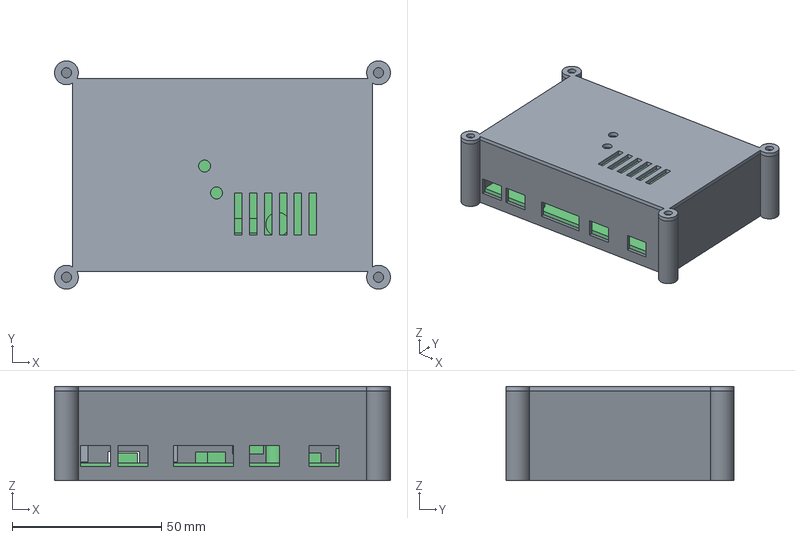
[picture p44: CAD file, 2026-10-26]
KiCAD/CoffeeRoast-Control-RevD-Balanced/mechanical/enclosure/generated/assembly_closed.step
112.4 x 76.4 x 31.6 mm
tray
board_proxy
lid
