smicbee/CoffeeRoast/KiCAD/CoffeeRoast-Control-RevD-Balanced/mechanical/enclosure/openscad/generated/board_proxy.stl

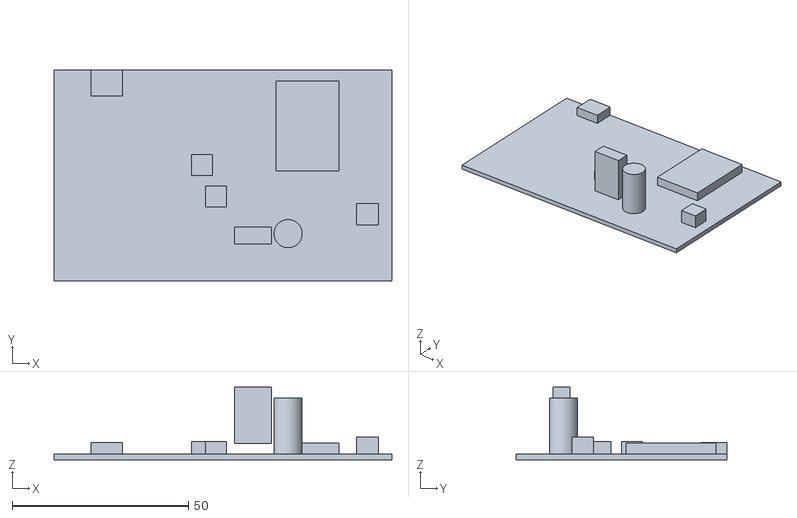
[picture p45: CAD file, 2026-10-26]
KiCAD/CoffeeRoast-Control-RevD-Balanced/mechanical/enclosure/openscad/generated/board_proxy.stl
96.0 x 60.0 x 20.6
