smicbee/CoffeeRoast/mechanical/stacked-controller-psu-enclosure/openscad/generated/lid_design.stl

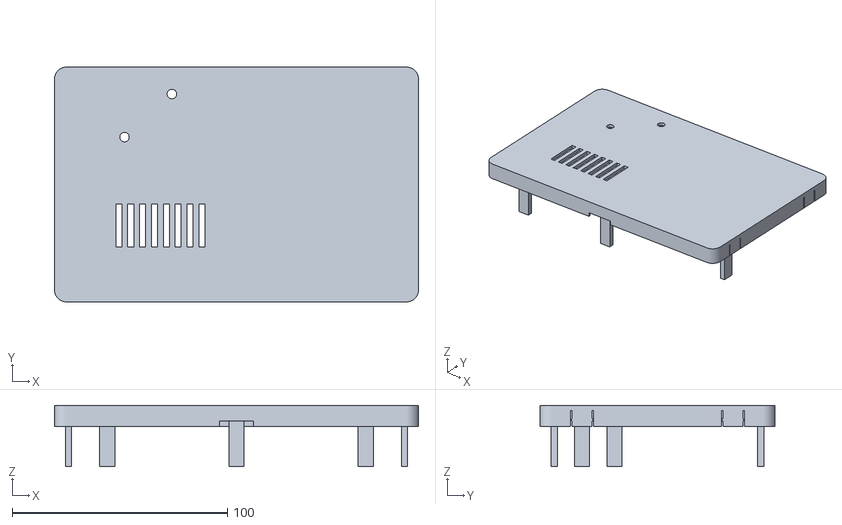
[picture p46: CAD file, 2026-10-26]
mechanical/stacked-controller-psu-enclosure/openscad/generated/lid_design.stl
169.0 x 109.0 x 28.6
