smicbee/CoffeeRoast/KiCAD/CoffeeRoast-Control-RevD-Balanced/mechanical/enclosure/generated/tray.step

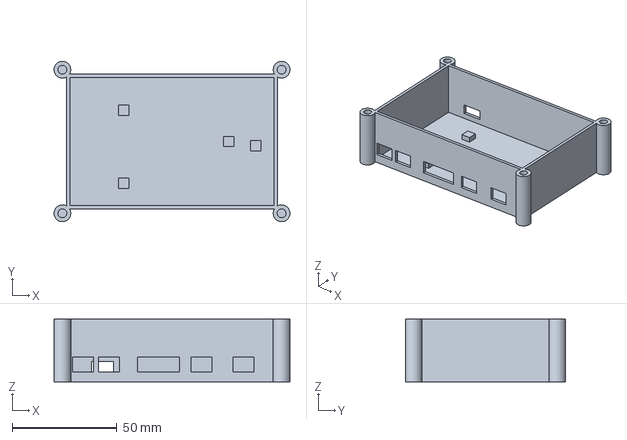
[picture p47: CAD file, 2026-10-26]
KiCAD/CoffeeRoast-Control-RevD-Balanced/mechanical/enclosure/generated/tray.step
112.4 x 76.4 x 30.0 mm
