smicbee/CoffeeRoast/KiCAD/CoffeeRoast-Control-RevD-Balanced/mechanical/enclosure/openscad/generated/lid_design.stl

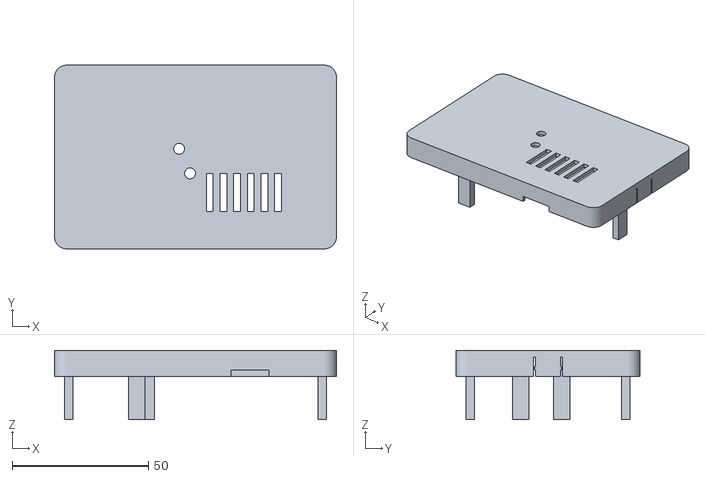
[picture p48: CAD file, 2026-10-26]
KiCAD/CoffeeRoast-Control-RevD-Balanced/mechanical/enclosure/openscad/generated/lid_design.stl
103.4 x 67.4 x 25.4
