smicbee/CoffeeRoast/mechanical/stacked-controller-psu-enclosure/openscad/generated/psu_proxy.stl

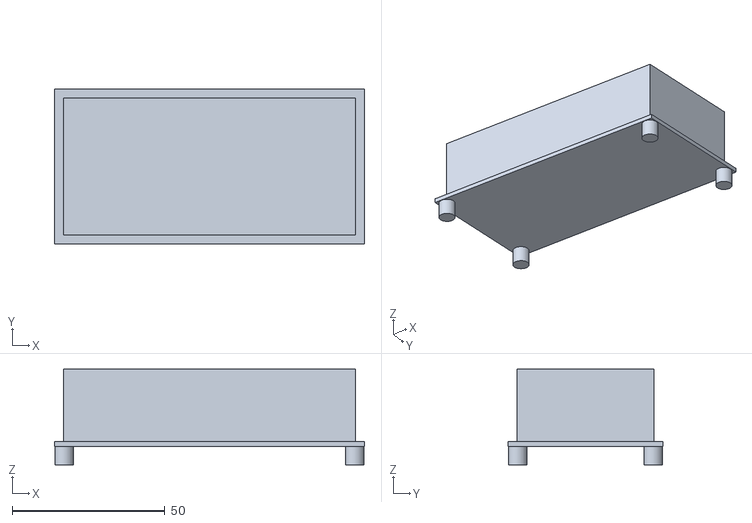
[picture p49: CAD file, 2026-10-26]
mechanical/stacked-controller-psu-enclosure/openscad/generated/psu_proxy.stl
101.6 x 50.8 x 31.4
