smicbee/CoffeeRoast/KiCAD/CoffeeRoast-Control-RevD-Balanced/mechanical/enclosure/generated/lid.step

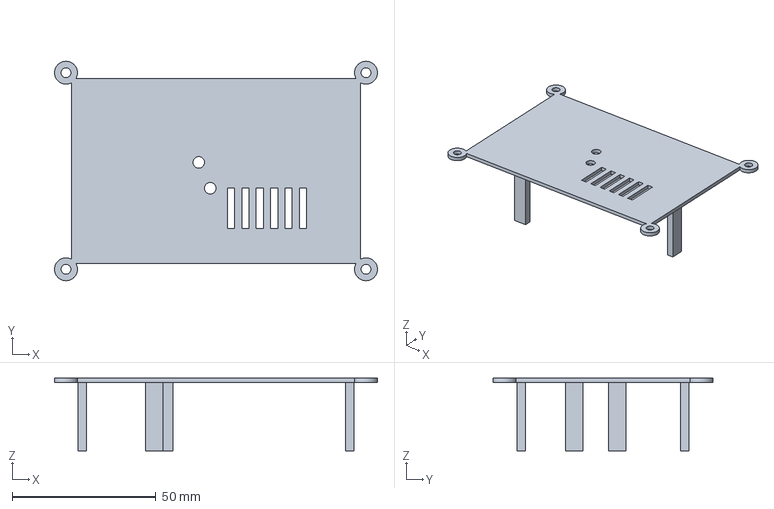
[picture p50: CAD file, 2026-10-26]
KiCAD/CoffeeRoast-Control-RevD-Balanced/mechanical/enclosure/generated/lid.step
112.4 x 76.4 x 25.4 mm
