smicbee/CoffeeRoast/KiCAD/CoffeeRoast-Control-RevD-Balanced/mechanical/enclosure/openscad/generated/lid_rails_attached_print.3mf

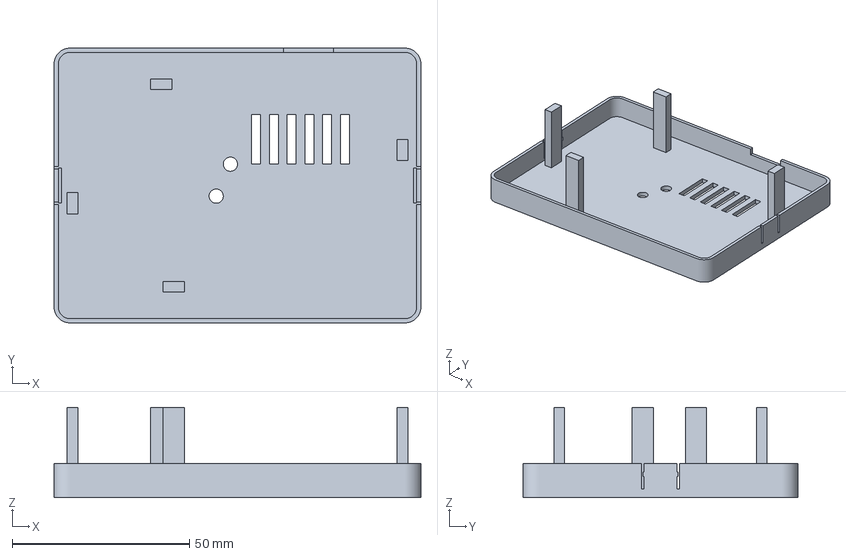
[picture p51: CAD file, 2026-10-26]
KiCAD/CoffeeRoast-Control-RevD-Balanced/mechanical/enclosure/openscad/generated/lid_rails_attached_print.3mf
103.4 x 77.4 x 25.4 mm
