smicbee/CoffeeRoast/mechanical/stacked-controller-psu-enclosure/openscad/generated/controller_deck.3mf

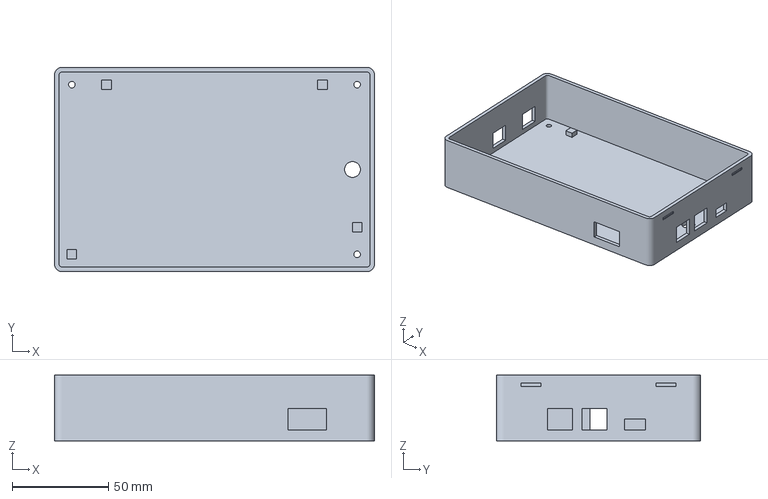
[picture p52: CAD file, 2026-10-26]
mechanical/stacked-controller-psu-enclosure/openscad/generated/controller_deck.3mf
166.0 x 106.0 x 34.0 mm
