smicbee/CoffeeRoast/mechanical/stacked-controller-psu-enclosure/openscad/generated/pcb_proxy.stl

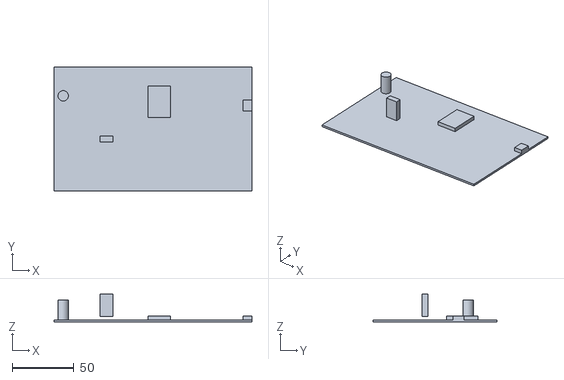
[picture p54: CAD file, 2026-10-26]
mechanical/stacked-controller-psu-enclosure/openscad/generated/pcb_proxy.stl
160.0 x 100.0 x 22.6
