smicbee/CoffeeRoast/mechanical/stacked-controller-psu-enclosure/openscad/generated/lower_base.3mf

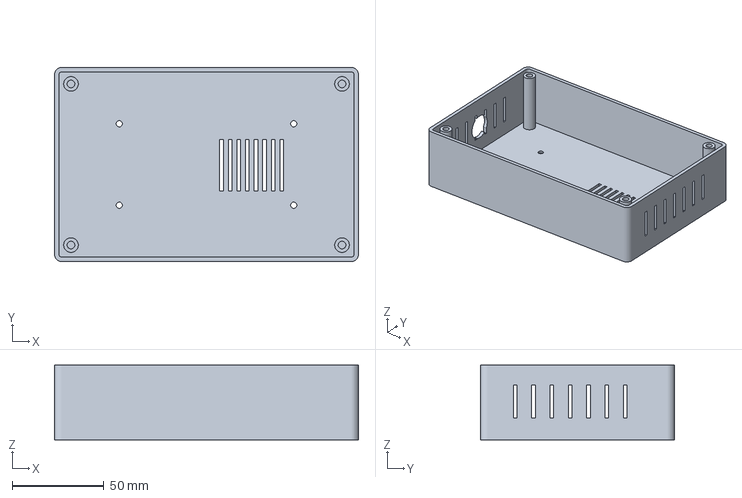
[picture p55: CAD file, 2026-10-26]
mechanical/stacked-controller-psu-enclosure/openscad/generated/lower_base.3mf
166.0 x 106.0 x 40.8 mm
