smicbee/CoffeeRoast/KiCAD/CoffeeRoast-Control-RevD-Balanced/mechanical/enclosure/openscad/generated/tray_rails_attached.3mf

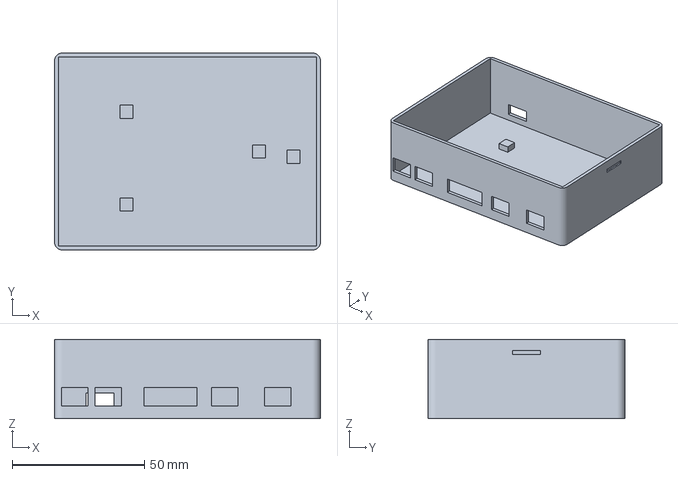
[picture p56: CAD file, 2026-10-26]
KiCAD/CoffeeRoast-Control-RevD-Balanced/mechanical/enclosure/openscad/generated/tray_rails_attached.3mf
100.4 x 74.4 x 30.0 mm
