smicbee/CoffeeRoast/KiCAD/CoffeeRoast-Control-RevD-Balanced/mechanical/enclosure/openscad/generated/board_proxy_rails_attached.stl

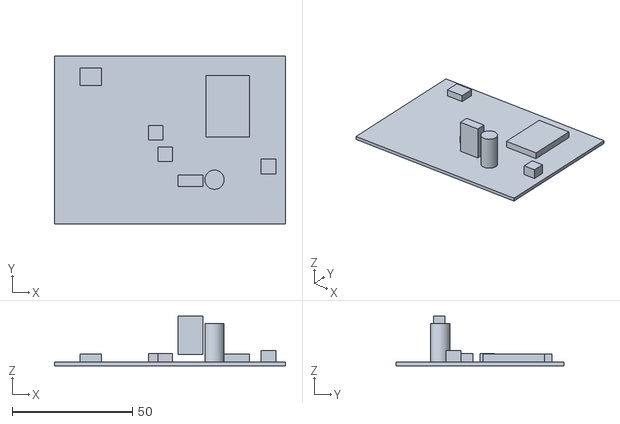
[picture p57: CAD file, 2026-10-26]
KiCAD/CoffeeRoast-Control-RevD-Balanced/mechanical/enclosure/openscad/generated/board_proxy_rails_attached.stl
96.0 x 70.0 x 20.6
