smicbee/CoffeeRoast/(list of files, cad)

Other CAD files:
KiCAD/CoffeeRoast-Control-RevD-Balanced/mechanical/enclosure/generated/lid_print.step
KiCAD/CoffeeRoast-Control-RevD-Balanced/mechanical/enclosure/generated/board_proxy.step
KiCAD/CoffeeRoast-Control-RevD-Balanced/mechanical/enclosure/openscad/generated/lid_print.3mf
mechanical/stacked-controller-psu-enclosure/openscad/generated/lid_print.3mf
KiCAD/CoffeeRoast-Control-RevD-Balanced/mechanical/enclosure/generated/board_proxy.stl
KiCAD/CoffeeRoast-Control-RevD-Balanced/mechanical/enclosure/generated/lid.stl
KiCAD/CoffeeRoast-Control-RevD-Balanced/mechanical/enclosure/generated/lid_print.3mf
KiCAD/CoffeeRoast-Control-RevD-Balanced/mechanical/enclosure/generated/lid_print.stl
KiCAD/CoffeeRoast-Control-RevD-Balanced/mechanical/enclosure/generated/tray.3mf
KiCAD/CoffeeRoast-Control-RevD-Balanced/mechanical/enclosure/generated/tray.stl
KiCAD/CoffeeRoast-Control-RevD-Balanced/mechanical/enclosure/openscad/generated/lid_print.stl
KiCAD/CoffeeRoast-Control-RevD-Balanced/mechanical/enclosure/openscad/generated/lid_rails_attached_print.stl
KiCAD/CoffeeRoast-Control-RevD-Balanced/mechanical/enclosure/openscad/generated/tray.stl
KiCAD/CoffeeRoast-Control-RevD-Balanced/mechanical/enclosure/openscad/generated/tray_rails_attached.stl
mechanical/stacked-controller-psu-enclosure/openscad/generated/controller_deck.stl
mechanical/stacked-controller-psu-enclosure/openscad/generated/lid_print.stl
mechanical/stacked-controller-psu-enclosure/openscad/generated/lower_base.stl
