smicbee/CoffeeRoast/KiCAD/CoffeeRoast-Control-RevA/render/3d/assembled_iso.png

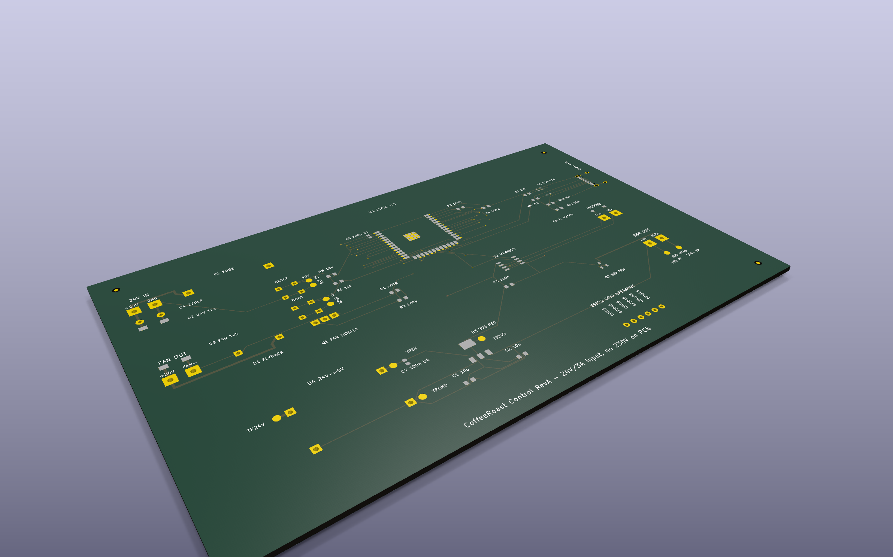
KiCAD/CoffeeRoast-Control-RevA/render/3d/assembled_iso.png
