smicbee/CoffeeRoast/KiCAD/CoffeeRoast-Control-RevA/render/3d/assembled_top.png

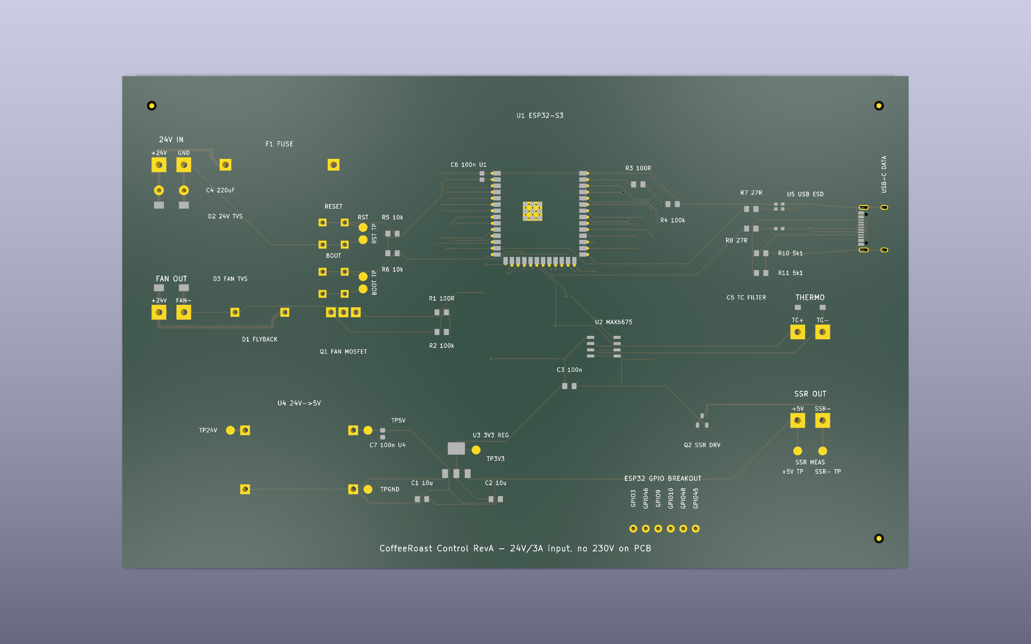
KiCAD/CoffeeRoast-Control-RevA/render/3d/assembled_top.png
