smicbee/CoffeeRoast/KiCAD/CoffeeRoast-Control-RevA/render/3d/assembled_usb_edge.png

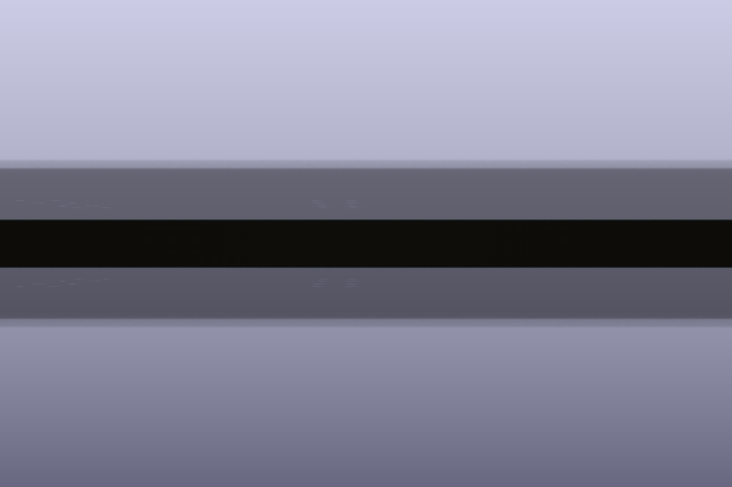
KiCAD/CoffeeRoast-Control-RevA/render/3d/assembled_usb_edge.png
