smicbee/CoffeeRoast/KiCAD/CoffeeRoast-Control-RevA/sim/results/mosfet_loss_sweep.csv

current_a | rds_on_mohm | mosfet_power_w
1.0 | 5 | 0.005
1.0 | 10 | 0.01
1.0 | 20 | 0.02
1.0 | 50 | 0.05
1.0 | 100 | 0.1
2.0 | 5 | 0.02
2.0 | 10 | 0.04
2.0 | 20 | 0.08
2.0 | 50 | 0.2
2.0 | 100 | 0.4
2.5 | 5 | 0.03125
2.5 | 10 | 0.0625
2.5 | 20 | 0.125
2.5 | 50 | 0.3125
2.5 | 100 | 0.625
3.0 | 5 | 0.045
3.0 | 10 | 0.09
3.0 | 20 | 0.18
3.0 | 50 | 0.45
3.0 | 100 | 0.9
