smicbee/CoffeeRoast/KiCAD/CoffeeRoast-Control-RevA/sim/results/regulator_heat_comparison.csv

load_current_a | ams1117_heat_w_5v_to_3v3 | switcher_input_power_w_at_90pct | switcher_heat_w_at_90pct
0.15 | 0.255 | 0.5499999999999999 | 0.05499999999999999
0.25 | 0.42500000000000004 | 0.9166666666666666 | 0.09166666666666667
0.35 | 0.595 | 1.283333333333333 | 0.1283333333333332
0.5 | 0.8500000000000001 | 1.8333333333333333 | 0.18333333333333335
