smicbee/CoffeeRoast/KiCAD/CoffeeRoast-Control-RevA/sim/results/fan_pwm_rl_model.csv

duty | freq_hz | i_avg_a | i_min_a | i_max_a | i_ripple_a | mosfet_p_avg_w | flyback_diode_p_avg_w
0.25 | 20000.0 | 0.5443124424908218 | 0.43628358378948506 | 0.6617403060704964 | 0.22545672228101132 | 0.0014293137945353238 | 0.2899993866598068
0.5 | 20000.0 | 1.2111773602213034 | 1.0494401054790914 | 1.3664934145548058 | 0.3170533090757144 | 0.014703036943099927 | 0.425444597776404
0.75 | 20000.0 | 1.828224284264318 | 1.7048804709590943 | 1.9424032219050524 | 0.2375227509459581 | 0.04949797639620738 | 0.33311651179618534
1.0 | 20000.0 | 2.4948024948024723 | 2.4948024948024723 | 2.4948024948024723 | 0.0 | 0.1244807897614528 | 0.0
