smicbee/CoffeeRoast/KiCAD/CoffeeRoast-Control-RevA/sim/results/input_bulk_holdup.csv

load_current_a | bulk_cap_uf | time_for_1v_sag_ms
0.2 | 220 | 1.0999999999999999
0.2 | 470 | 2.3499999999999996
0.2 | 1000 | 5.0
0.5 | 220 | 0.43999999999999995
0.5 | 470 | 0.94
0.5 | 1000 | 2.0
1.0 | 220 | 0.21999999999999997
1.0 | 470 | 0.47
1.0 | 1000 | 1.0
2.5 | 220 | 0.088
2.5 | 470 | 0.188
2.5 | 1000 | 0.4
3.0 | 220 | 0.07333333333333333
3.0 | 470 | 0.15666666666666665
3.0 | 1000 | 0.3333333333333333
