smicbee/CoffeeRoast/KiCAD/CoffeeRoast-Control-RevA/sim/results/ssr_driver_current_sweep.csv

ssr_input_equiv_ohm | estimated_ssr_led_current_ma | q2_power_mw_at_vsat_0p1 | gpio_gate_static_current_ma
330 | 11.515151515151516 | 1.1515151515151514 | 3.2967032967032964e-05
680 | 5.588235294117647 | 0.5588235294117647 | 3.2967032967032964e-05
1000 | 3.8 | 0.38 | 3.2967032967032964e-05
1500 | 2.533333333333333 | 0.25333333333333335 | 3.2967032967032964e-05
2200 | 1.7272727272727273 | 0.17272727272727276 | 3.2967032967032964e-05
