smicbee/CoffeeRoast/KiCAD/CoffeeRoast-Control-RevA/render/drc_5fix_stable_full.txt

** Drc report for CoffeeRoast-Control-RevA.kicad_pcb **
** Created on 2026-07-06T21:50:52+0200 **
** Report includes: Fehler, Warnungen **

** Found 0 DRC violations **

** Found 0 unconnected pads **

** Found 0 Footprint errors **

** End of Report **
