smicbee/CoffeeRoast/KiCAD/CoffeeRoast-Control-RevA/render/kicad_happy/pcb_pre_fix.txt

=== Design Analysis [stage: pre_fab] ===

--- assembly ---
  [1] INFO FD-001: No fiducials on B.Cu (40 SMD components) (finest pad dim 1.15mm — coarse pitch only)
      Detail: B.Cu has 0 fiducial(s) but 40 SMD components. Assembly machines need >= 3 fiducials for accurate placement.
      Fix:    Add fiducial markers for pick-and-place alignment (3 per side with SMD).
      Stages: pre_fab
  [2] ERROR FD-001: No fiducials on F.Cu (66 SMD components) (finest pad dim 0.30mm — BGA/fine-pitch QFN present)
      Detail: F.Cu has 0 fiducial(s) but 66 SMD components. Assembly machines need >= 3 fiducials for accurate placement.
      Fix:    Add fiducial markers for pick-and-place alignment (3 per side with SMD).
      Stages: pre_fab

--- current_capacity ---
  [3] INFO CC-DET: Power net +24V_FUSED: 0.2mm min trace
      Detail: Power/ground net +24V_FUSED: min trace 0.2mm, max 0.45mm, 14 segments.
      Stages: layout, pre_fab
  [4] INFO CC-DET: Power net +24V_RAW: 0.2mm min trace
      Detail: Power/ground net +24V_RAW: min trace 0.2mm, max 0.45mm, 8 segments.
      Stages: layout, pre_fab
  [5] INFO CC-DET: Power net +3V3: 0.2mm min trace
      Detail: Power/ground net +3V3: min trace 0.2mm, max 0.22mm, 27 segments.
      Stages: layout, pre_fab
  [6] INFO CC-DET: Power net +5V: 0.2mm min trace
      Detail: Power/ground net +5V: min trace 0.2mm, max 0.25mm, 17 segments.
      Stages: layout, pre_fab
  [7] INFO CC-DET: Power net GND: 0.2mm min trace
      Detail: Power/ground net GND: min trace 0.2mm, max 0.45mm, 101 segments.
      Stages: layout, pre_fab

--- testability ---
  [8] INFO TE-001: Test point coverage: 37/48 nets (77%)
      Detail: 37 of 48 signal nets have test points (77% coverage).
      Fix:    Add test points to improve ICT/flying probe coverage.
      Stages: pre_fab

Total: 8 (1 error, 0 warnings, 7 info)
