smicbee/CoffeeRoast/KiCAD/CoffeeRoast-Control-RevA/render/schematic/CoffeeRoast-Control-RevA.pdf

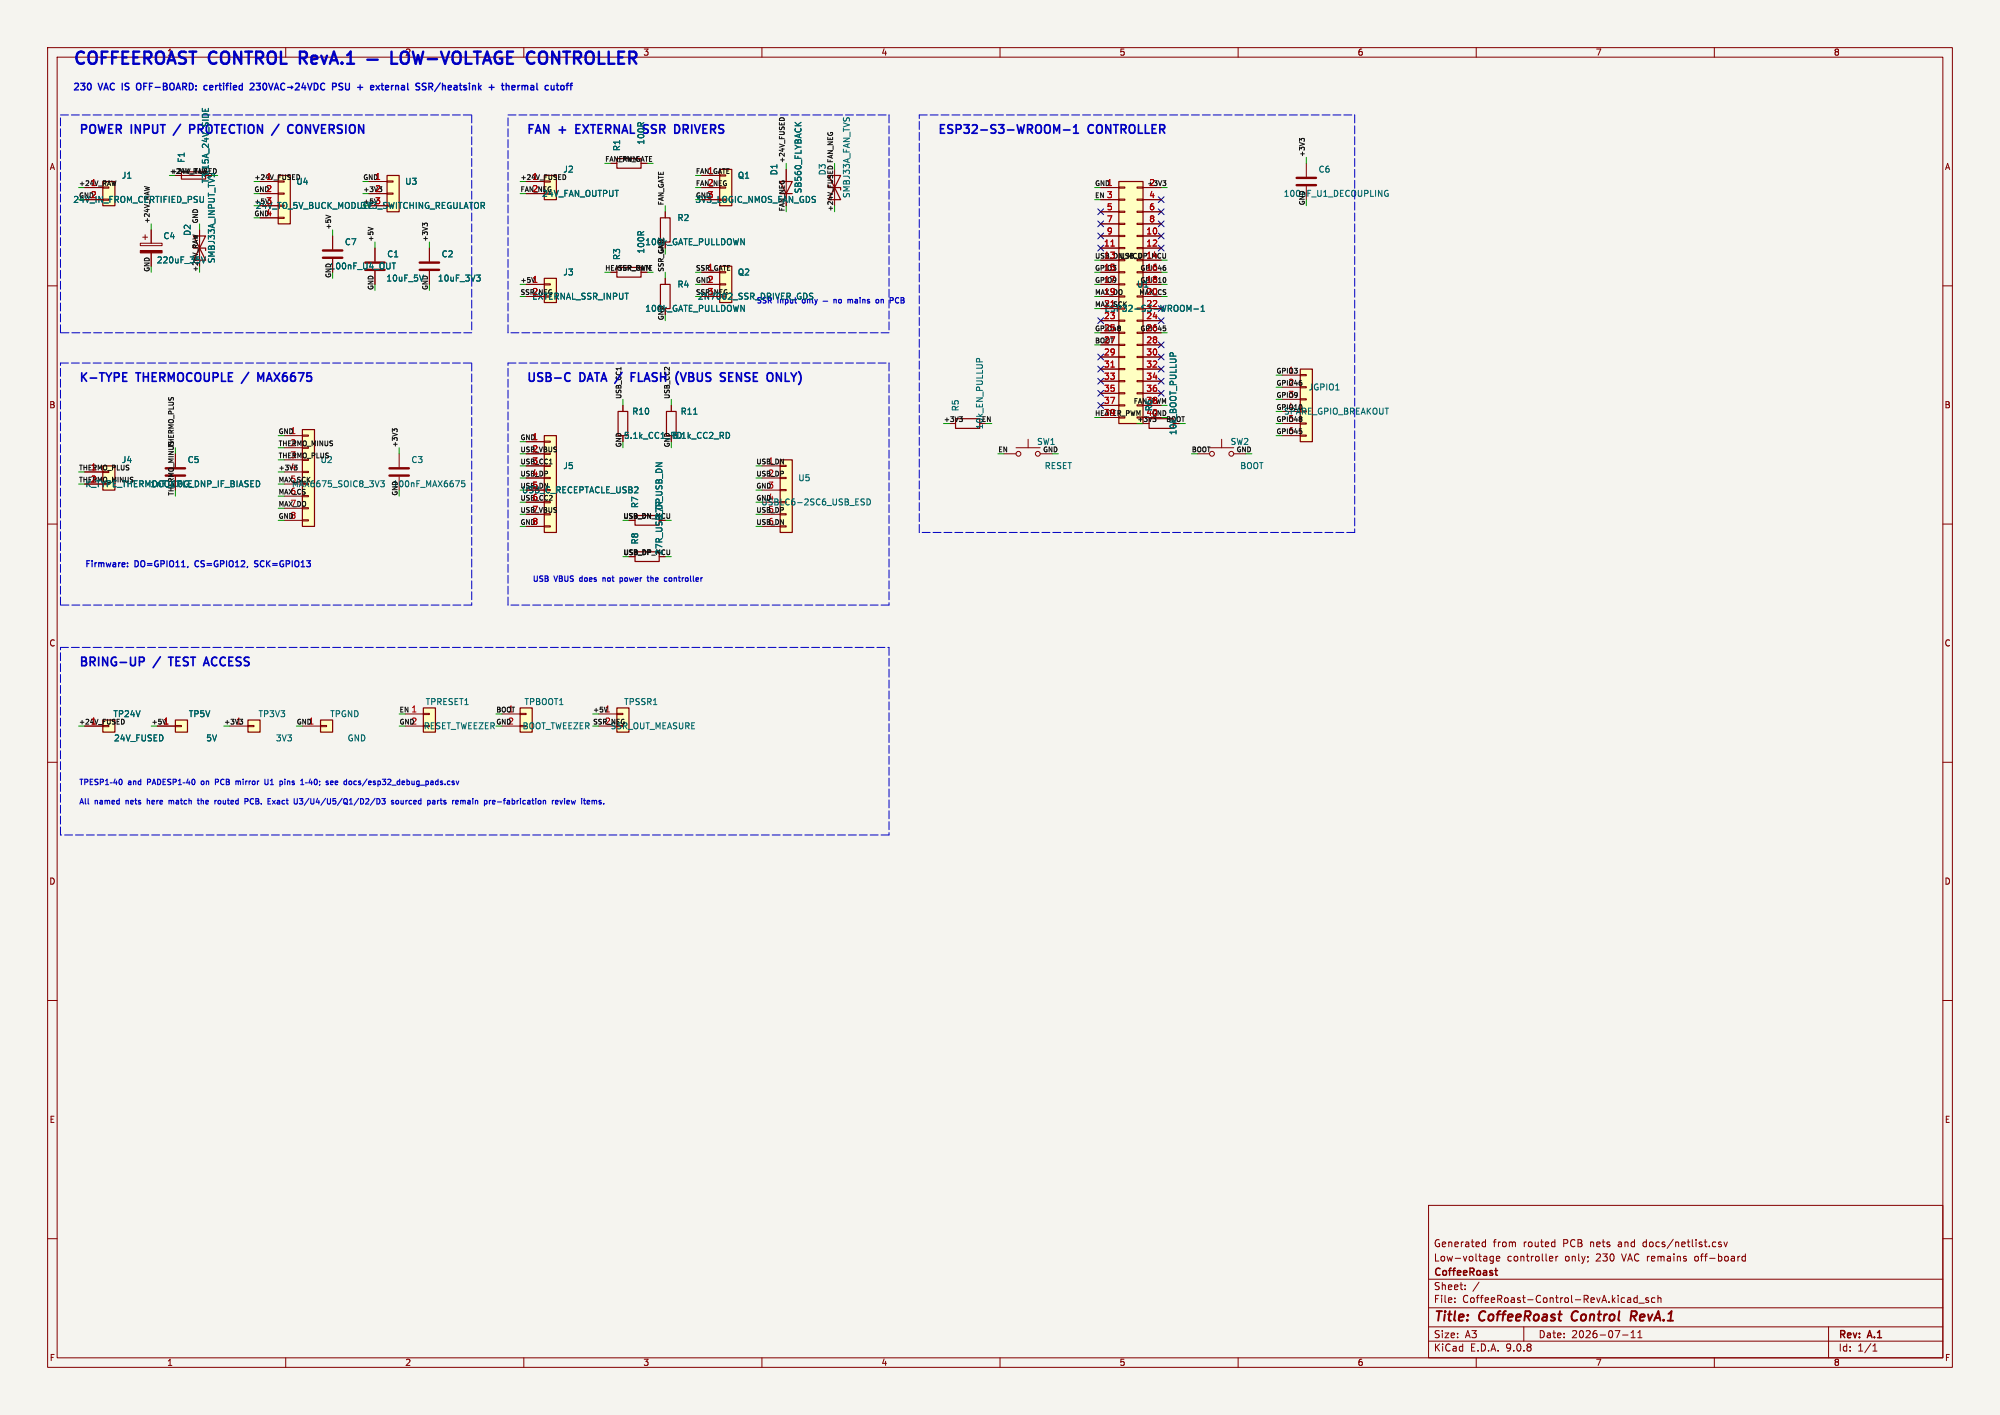
[picture p61: page 1]

POWER INPUT / PROTECTION / CONVERSION

FAN + EXTERNAL SSR DRIVERS

Id: 1/1 Title: CoffeeRoast Control RevA.1
