smicbee/CoffeeRoast/(list of files, drawings)

Other design files:
KiCAD/CoffeeRoast-Control-RevA/render/coffeeroast_debug_breakout.dsn
KiCAD/CoffeeRoast-Control-RevA/render/coffeeroast_exact_usb.dsn
KiCAD/CoffeeRoast-Control-RevA/render/coffeeroast_reva2.dsn
KiCAD/CoffeeRoast-Control-RevA/render/gpio_row_unrouted.dsn
KiCAD/CoffeeRoast-Control-RevA/render/kicad_happy/pcb_5fix.json
KiCAD/CoffeeRoast-Control-RevA/render/kicad_happy/pcb_5fix_norm.json
KiCAD/CoffeeRoast-Control-RevA/render/kicad_happy/pcb_before_5fix.json
KiCAD/CoffeeRoast-Control-RevA/render/kicad_happy/pcb_gpio_labels.json
KiCAD/CoffeeRoast-Control-RevA/render/kicad_happy/pcb_post_fix.json
KiCAD/CoffeeRoast-Control-RevA/render/kicad_happy/pcb_reset_boot_ssr_testpads.json
KiCAD/CoffeeRoast-Control-RevA/render/kicad_happy/pcb_score_now.json
KiCAD/CoffeeRoast-Control-RevA/render/kicad_happy/pcb_usb_no_notch.json
KiCAD/CoffeeRoast-Control-RevA/render/kicad_happy/schematic_post_fix.json
