smicbee/CoffeeRoast/KiCAD/CoffeeRoast-Control-RevA/CoffeeRoast-Control-RevA.kicad_pcb

## KiCad design KiCAD/CoffeeRoast-Control-RevA/CoffeeRoast-Control-RevA.kicad_pcb (2026-07-10)

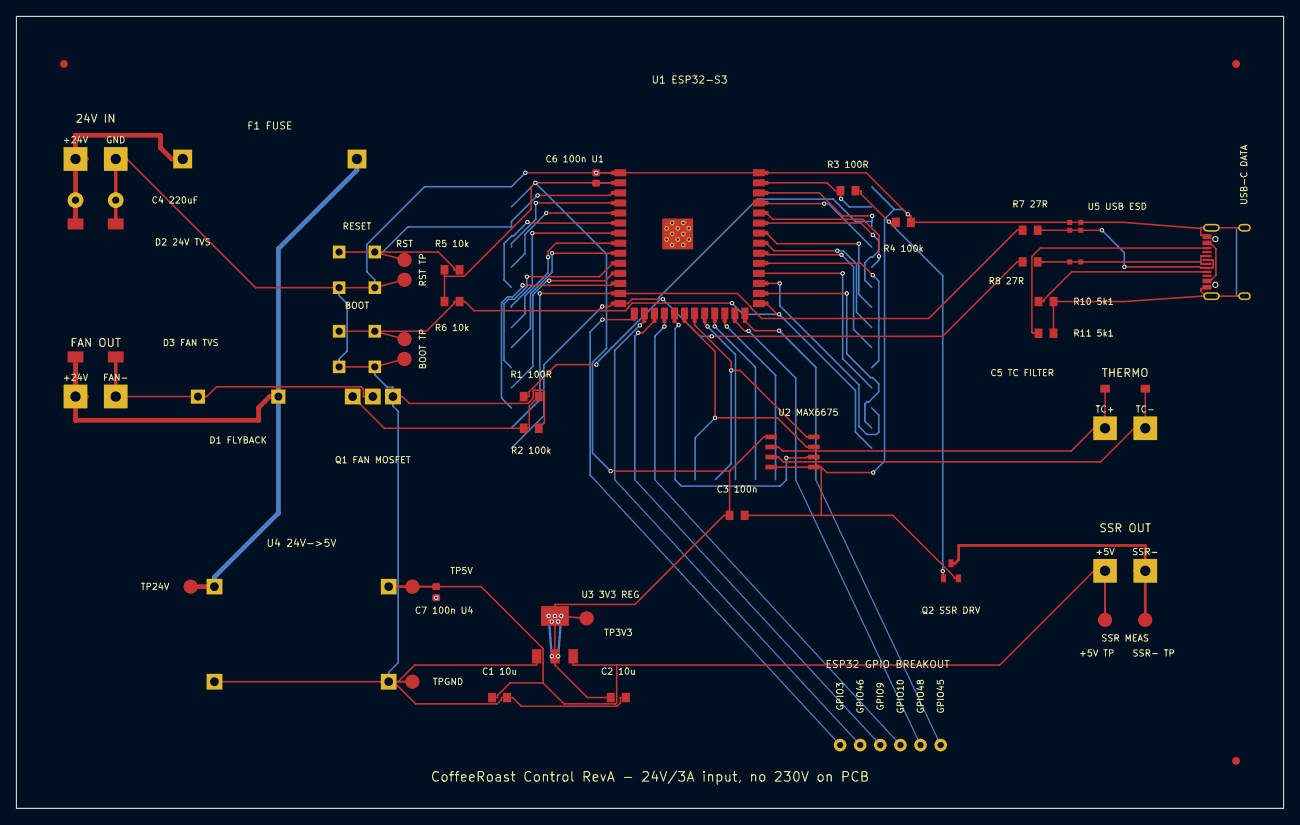
[picture p62: board CoffeeRoast-Control-RevA.kicad_pcb from above]

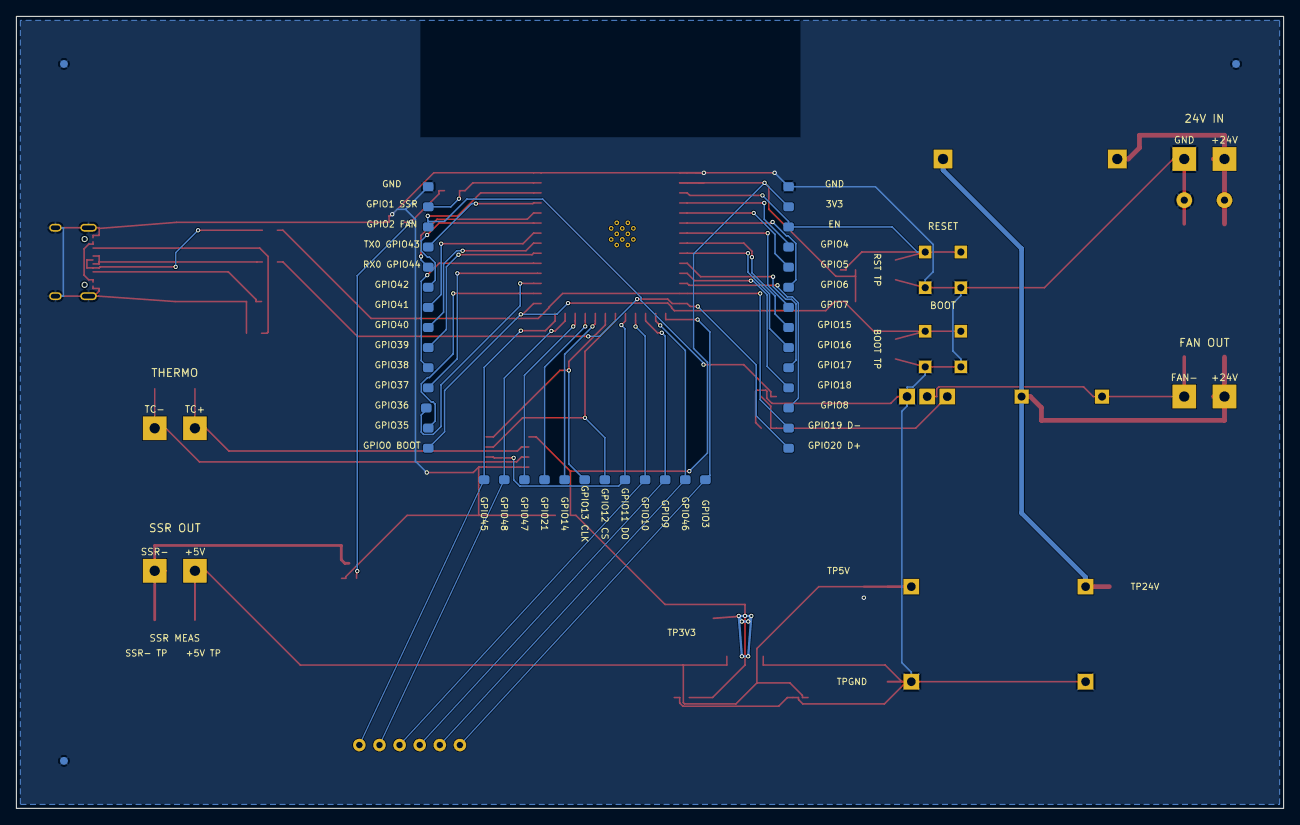
[picture p63: board CoffeeRoast-Control-RevA.kicad_pcb from below]

Board: 2 copper layers, 160.0 x 100.0 mm, 129 parts (43 on the bottom side), 53 nets.

Parts:
C1: 10uF_5V
C2: 10uF_3V3
C3: 100nF_MAX6675
C4: 220uF_35V_INPUT_BULK
C5: 1nF_C0G_THERMO_DIFF_FILTER_DNP_IF_NOISY
C6: 100nF_U1_DECOUPLING_0603
C7: 100nF_U4_OUTPUT_DECOUPLING_0603
D1: SB560_FLYBACK
D2: SMBJ33A_24V_INPUT_TVS
D3: SMBJ33A_FAN_TVS
F1: T3.15A_24V_SIDE
FID1, FID2, FID3, FID4, FID5, FID6: FIDUCIAL_GLOBAL_1MM
J1: 24V_IN_FROM_230V_PSU_3A
J2: FAN_24V_PWM_3A
J3: SSR_INPUT_TO_EXTERNAL_SSR
J4: K_TYPE_THERMOCOUPLE
J5: USB_C_Receptacle_XKB_U262-16XN-4BVC11
JGPIO1: ESP32_GPIO_BREAKOUT_ROW
PADESP1, PADESP40: GND
PADESP2: 3V3
PADESP3: EN
PADESP4: IO4
PADESP5: IO5
PADESP6: IO6
PADESP7: IO7
PADESP8: IO15
PADESP9: IO16
PADESP10: IO17
PADESP11: IO18
PADESP12: IO8
PADESP13: USB_D-
PADESP14: USB_D+
PADESP15: IO3
PADESP16: IO46
PADESP17: IO9
PADESP18: IO10
PADESP19: IO11
PADESP20: IO12
PADESP21: IO13
PADESP22: IO14
PADESP23: IO21
PADESP24: IO47
PADESP25: IO48
PADESP26: IO45
PADESP27: IO0
PADESP28: IO35
PADESP29: IO36
PADESP30: IO37
PADESP31: IO38
PADESP32: IO39
PADESP33: IO40
PADESP34: IO41
PADESP35: IO42
PADESP36: RXD0
PADESP37: TXD0
PADESP38: IO2
PADESP39: IO1
Q1: IRLB8721_OR_3V3_LOGIC_NMOS_RDS_ON_LOW
Q2: 2N7002_SSR_DRIVER
R1, R3: 100R
R2, R4: 100k
R5: 10k_EN_PULLUP
R6: 10k_BOOT_PULLUP
R7: 27R_USB_DN
R8: 27R_USB_DP
R10: 5k1_CC1_RD
R11: 5k1_CC2_RD
SW1: RESET_EN
SW2: BOOT
TP3V3: +3V3_TEST
TP5V: +5V_TEST
TP24V: +24V_FUSED_TEST
TPBOOT1: BOOT_TWEEZER_PADS
TPESP1, TPESP40: GND
TPESP2: 3V3
TPESP3: EN
TPESP4: IO4
TPESP5: IO5
TPESP6: IO6
TPESP7: IO7
TPESP8: IO15
TPESP9: IO16
TPESP10: IO17
TPESP11: IO18
TPESP12: IO8
TPESP13: USB_D-/IO19
TPESP14: USB_D+/IO20
TPESP15: IO3
TPESP16: IO46
TPESP17: IO9
TPESP18: IO10
TPESP19: IO11/MAXDO
TPESP20: IO12/MAXCS
TPESP21: IO13/MAXCLK
TPESP22: IO14
TPESP23: IO21
TPESP24: IO47
TPESP25: IO48
TPESP26: IO45
TPESP27: IO0/BOOT
TPESP28: IO35
TPESP29: IO36
TPESP30: IO37
TPESP31: IO38
TPESP32: IO39
TPESP33: IO40
TPESP34: IO41
TPESP35: IO42
TPESP36: RXD0/IO44
TPESP37: TXD0/IO43
TPESP38: IO2/FAN
TPESP39: IO1/SSR
TPGND: GND_TEST
TPRESET1: RESET_TWEEZER_PADS
TPSSR1: SSR_OUT_MEAS_PADS
U1: ESP32-S3-WROOM-1
U2: MAX6675_SOIC8_3V3
U3: 3V3_SWITCHING_REGULATOR_>=600mA_5V_IN_REPLACES_AM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
U4: 24V_TO_5V_BUCK_MODULE_>=1A_LOW_NOISE
U5: USBLC6-2SC6_OR_USB2_ESD

Connections:
+3V3: C2.1, C3.1, C6.1, PADESP2.1, R5.1, R6.1, TP3V3.1, TPESP2.1, U1.2, U2.4, U3.2
+5V: C1.1, C7.1, J3.1, TP5V.1, TPSSR1.1, U3.3, U4.3
+24V_FUSED: D1.2, D3.1, F1.2, J2.1, TP24V.1, U4.1
+24V_RAW: C4.1, D2.1, F1.1, J1.1
BOOT: PADESP27.1, R6.2, SW2.1, SW2.2, TPBOOT1.1, TPESP27.1, U1.27
EN: PADESP3.1, R5.2, SW1.1, SW1.2, TPESP3.1, TPRESET1.1, U1.3
FAN_GATE: Q1.1, R1.2, R2.1
FAN_NEG: D1.1, D3.2, J2.2, Q1.2
FAN_PWM: PADESP38.1, R1.1, TPESP38.1, U1.38
GND: C1.2, C2.2, C3.2, C4.2, C6.2, C7.2, D2.2, FID4.1, FID5.1, FID6.1, J1.2, J5.A1, J5.A12, J5.B1, J5.B12, J5.S1, PADESP1.1, PADESP40.1, Q1.3, Q2.2, R2.2, R4.2, R10.2, R11.2, SW1.3, SW1.4, SW2.3, SW2.4, TPBOOT1.2, TPESP1.1, TPESP40.1, TPGND.1, TPRESET1.2, U1.1, U1.40, U2.1, U2.8, U3.1, U4.2, U4.4, U5.3, U5.4
GPIO3: JGPIO1.1, PADESP15.1, TPESP15.1, U1.15
GPIO4: PADESP4.1, TPESP4.1, U1.4
GPIO5: PADESP5.1, TPESP5.1, U1.5
GPIO6: PADESP6.1, TPESP6.1, U1.6
GPIO7: PADESP7.1, TPESP7.1, U1.7
GPIO8: PADESP12.1, TPESP12.1, U1.12
GPIO9: JGPIO1.3, PADESP17.1, TPESP17.1, U1.17
GPIO10: JGPIO1.4, PADESP18.1, TPESP18.1, U1.18
GPIO14: PADESP22.1, TPESP22.1, U1.22
GPIO15: PADESP8.1, TPESP8.1, U1.8
GPIO16: PADESP9.1, TPESP9.1, U1.9
GPIO17: PADESP10.1, TPESP10.1, U1.10
GPIO18: PADESP11.1, TPESP11.1, U1.11
GPIO21: PADESP23.1, TPESP23.1, U1.23
GPIO35: PADESP28.1, TPESP28.1, U1.28
GPIO36: PADESP29.1, TPESP29.1, U1.29
GPIO37: PADESP30.1, TPESP30.1, U1.30
GPIO38: PADESP31.1, TPESP31.1, U1.31
GPIO39: PADESP32.1, TPESP32.1, U1.32
GPIO40: PADESP33.1, TPESP33.1, U1.33
GPIO41: PADESP34.1, TPESP34.1, U1.34
GPIO42: PADESP35.1, TPESP35.1, U1.35
GPIO45: JGPIO1.6, PADESP26.1, TPESP26.1, U1.26
GPIO46: JGPIO1.2, PADESP16.1, TPESP16.1, U1.16
GPIO47: PADESP24.1, TPESP24.1, U1.24
GPIO48: JGPIO1.5, PADESP25.1, TPESP25.1, U1.25
HEATER_PWM: PADESP39.1, R3.1, TPESP39.1, U1.39
MAX_CS: PADESP20.1, TPESP20.1, U1.20, U2.6
MAX_DO: PADESP19.1, TPESP19.1, U1.19, U2.7
MAX_SCK: PADESP21.1, TPESP21.1, U1.21, U2.5
RXD0_GPIO44: PADESP36.1, TPESP36.1, U1.36
SSR_GATE: Q2.1, R3.2, R4.1
SSR_NEG: J3.2, Q2.3, TPSSR1.2
THERMO_MINUS: C5.2, J4.2, U2.2
THERMO_PLUS: C5.1, J4.1, U2.3
TXD0_GPIO43: PADESP37.1, TPESP37.1, U1.37
USB_CC1: J5.A5, R10.1
USB_CC2: J5.B5, R11.1
USB_DN: J5.A7, J5.B7, R7.2, U5.1, U5.6
USB_DN_MCU: PADESP13.1, R7.1, TPESP13.1, U1.13
USB_DP: J5.A6, J5.B6, R8.2, U5.2, U5.5
USB_DP_MCU: PADESP14.1, R8.1, TPESP14.1, U1.14
USB_VBUS: J5.A4, J5.A9, J5.B4, J5.B9
