smicbee/CoffeeRoast/(commit log)

2025-06-15 button shows state
2025-06-15 implemented failsafe after 20 error temperature readings
2025-06-15 invalid readings do not contribute to PID
2026-04-14 ticket: Updated 'Fix control loop timer interval scaling'
2026-04-17 ticket: Created 'Rework UI' [improvement/high]
    [RoastingControl.ino]
2026-04-18 ticket: Updated 'Add bounds checks before writing PID history arrays'
2026-07-04 Add CoffeeRoast control PCB RevA draft
    [CoffeeRoast-Control-RevA.kicad_pcb, CoffeeRoast-Control-RevA.kicad_sch, bom.csv, netlist.csv]
2026-07-04 Put USB-C connector on CoffeeRoast control PCB
    [CoffeeRoast-Control-RevA.kicad_pcb, bom.csv, netlist.csv]
2026-07-04 Render CoffeeRoast PCB with KiCad
    [CoffeeRoast-Control-RevA.kicad_pcb]
2026-07-04 Autoroute CoffeeRoast control PCB
    [CoffeeRoast-Control-RevA.kicad_pcb, bom.csv, coffeeroast_reva2.dsn]
2026-07-04 Replace USB-C draft with exact connector footprint
    [CoffeeRoast-Control-RevA.kicad_pcb, bom.csv, coffeeroast_exact_usb.dsn]
2026-07-04 Expose ESP32 pins as debug pads
    [CoffeeRoast-Control-RevA.kicad_pcb, bom.csv, esp32_debug_pads.csv, netlist.csv]
2026-07-04 Route labeled ESP32 solder pads outward
    [CoffeeRoast-Control-RevA.kicad_pcb, bom.csv, coffeeroast_debug_breakout.dsn, esp32_solder_pads.csv, netlist.csv]
2026-07-05 Improve CoffeeRoast RevA PCB robustness
    [CoffeeRoast-Control-RevA.kicad_pcb, CoffeeRoast-Control-RevA.kicad_sch, bom.csv, netlist.csv]
2026-07-05 Add partial SMD PCBA order package
    [CoffeeRoast-Control-RevA-B_Cu.gbl, CoffeeRoast-Control-RevA-B_Mask.gbs, CoffeeRoast-Control-RevA-B_Paste.gbp, CoffeeRoast-Control-RevA-B_Silkscreen.gbo, CoffeeRoast-Control-RevA-Edge_Cuts.gm1, CoffeeRoast-Control-RevA-F_Cu.gtl, CoffeeRoast-Control-RevA-F_Mask.gts, CoffeeRoast-Control-RevA-F_Paste.gtp]
2026-07-05 Add PCBA part mapping and sanity simulations
    [CoffeeRoast-Control-RevA-B_Cu.gbl, CoffeeRoast-Control-RevA-B_Mask.gbs, CoffeeRoast-Control-RevA-B_Paste.gbp, CoffeeRoast-Control-RevA-B_Silkscreen.gbo, CoffeeRoast-Control-RevA-Edge_Cuts.gm1, CoffeeRoast-Control-RevA-F_Cu.gtl, CoffeeRoast-Control-RevA-F_Mask.gts, CoffeeRoast-Control-RevA-F_Paste.gtp]
2026-07-05 Select CoffeeRoast PCBA components
    [CoffeeRoast-Control-RevA-B_Cu.gbl, CoffeeRoast-Control-RevA-B_Mask.gbs, CoffeeRoast-Control-RevA-B_Paste.gbp, CoffeeRoast-Control-RevA-B_Silkscreen.gbo, CoffeeRoast-Control-RevA-Edge_Cuts.gm1, CoffeeRoast-Control-RevA-F_Cu.gtl, CoffeeRoast-Control-RevA-F_Mask.gts, CoffeeRoast-Control-RevA-F_Paste.gtp]
2026-07-05 Add Q1 C2663 to Y4 max PCBA package
    [CoffeeRoast-Control-RevA-B_Cu.gbl, CoffeeRoast-Control-RevA-B_Mask.gbs, CoffeeRoast-Control-RevA-B_Paste.gbp, CoffeeRoast-Control-RevA-B_Silkscreen.gbo, CoffeeRoast-Control-RevA-Edge_Cuts.gm1, CoffeeRoast-Control-RevA-F_Cu.gtl, CoffeeRoast-Control-RevA-F_Mask.gts, CoffeeRoast-Control-RevA-F_Paste.gtp]
2026-07-05 Add Y4 gerber-only JLC upload zip
2026-07-05 Fix Y4 JLC CPL Y-axis placement
    [cpl_smd_partial_JLC_Y_corrected.csv]
2026-07-05 Fix JLC CPL Y-axis export
2026-07-10 fix: tolerate ESP32 reset during Web Serial handshake
2026-07-10 feat: update RevA PCB and production artifacts
    [CoffeeRoast-Control-RevA-B_Cu.gbl, CoffeeRoast-Control-RevA-B_Mask.gbs, CoffeeRoast-Control-RevA-B_Paste.gbp, CoffeeRoast-Control-RevA-B_Silkscreen.gbo, CoffeeRoast-Control-RevA-Edge_Cuts.gm1, CoffeeRoast-Control-RevA-F_Cu.gtl, CoffeeRoast-Control-RevA-F_Mask.gts, CoffeeRoast-Control-RevA-F_Paste.gtp]
2026-07-10 fix: align hardware protocol and branch roast flow
2026-07-10 fix: harden preheat airflow and temperature sensing
    [RoastingControl.ino]
2026-07-10 feat: add safe ESP32-S3 web firmware installer
2026-07-10 fix: latch failsafe and harden roast state transitions
    [RoastingControl.ino]
2026-07-11 fix: target Waveshare ESP32-S3-Zero only
    [RoastingControl.ino]
2026-07-11 fix: make preparation phase fan-only
2026-07-11 fix: start fan preparation directly and smooth profile corners
2026-07-11 feat: calibrate PID from completed roast curve
2026-07-11 feat: add full-range manual PID control with fan interlock
2026-07-11 feat: add complete CoffeeRoast KiCad schematic
    [CoffeeRoast-Control-RevA.kicad_sch]
2026-10-26 Add stacked RevA2 and LOP-200 enclosure
2026-10-26 Add existing RevD 96x60 enclosure sources and print artifacts
