smicbee/CoffeeRoast/docu/assets/img/rel/enjoy.webp

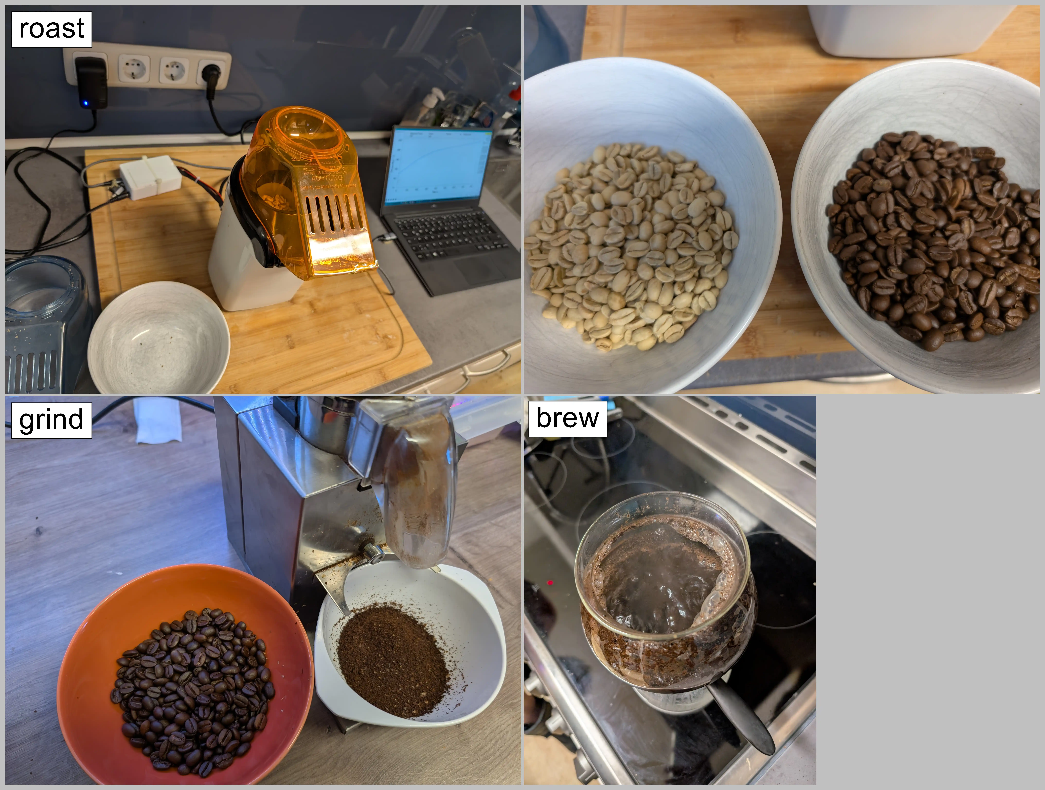
[picture p2: docu/assets/img/rel/enjoy.webp]
docu/assets/img/rel/enjoy.webp
