smicbee/CoffeeRoast/docu/assets/img/rel/prepare_roast.webp

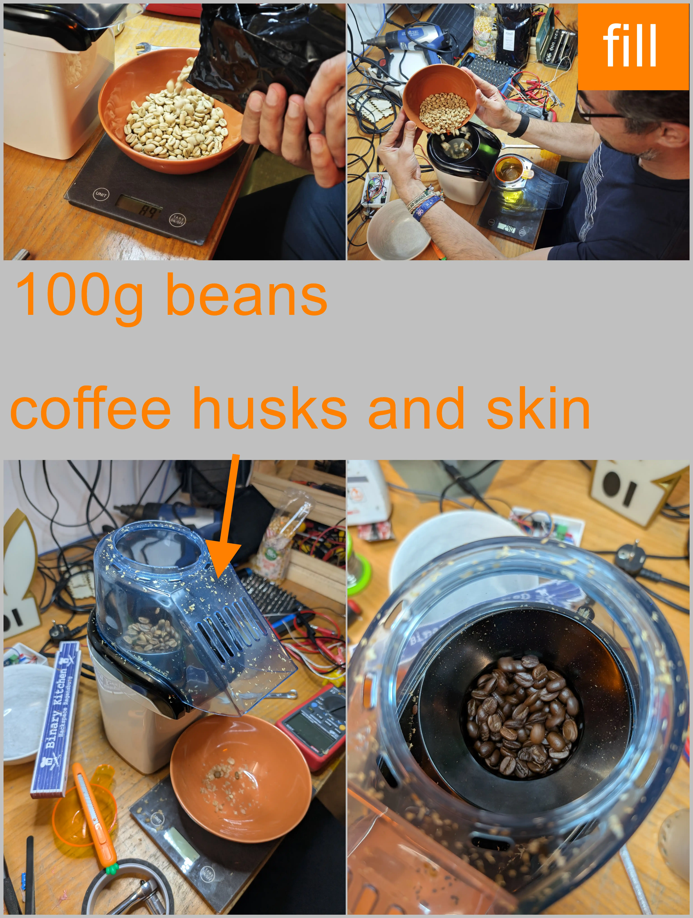
[picture p8: docu/assets/img/rel/prepare_roast.webp]
docu/assets/img/rel/prepare_roast.webp
